256592/Data_logger/04_Fotografie/final-v3/foto-bottom-b.jpg

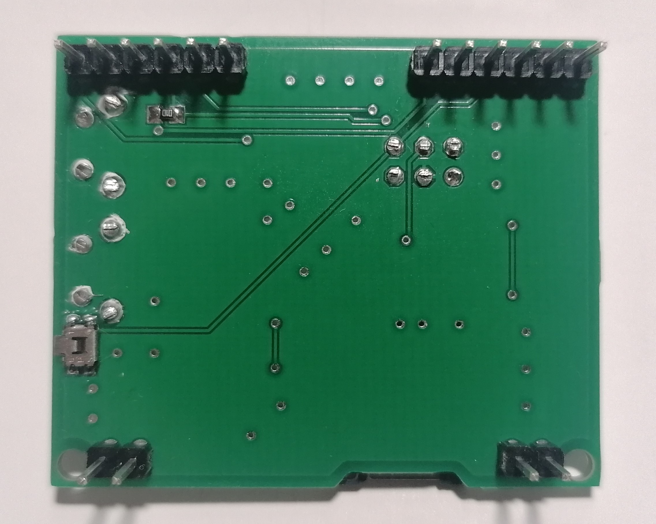
04_Fotografie/final-v3/foto-bottom-b.jpg
