256592/Data_logger/04_Fotografie/final-v3/foto-sestava-01.jpg

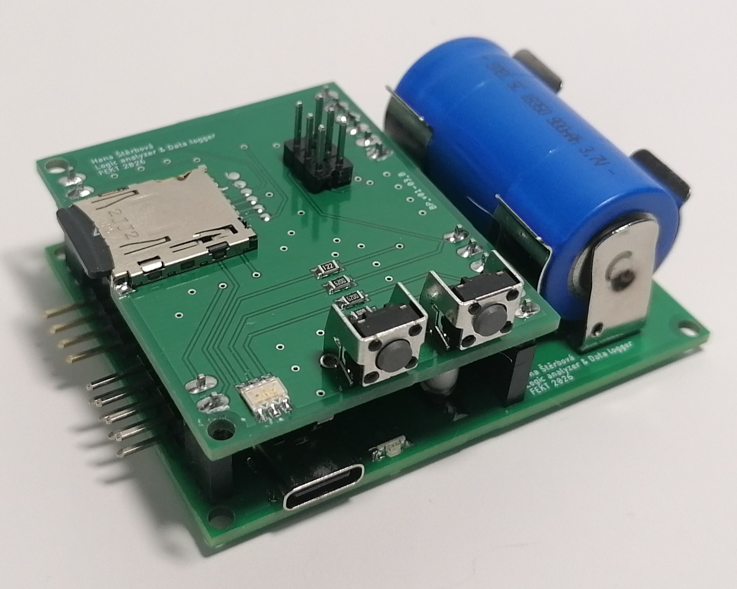
04_Fotografie/final-v3/foto-sestava-01.jpg
