256592/Data_logger/04_Fotografie/final-v3/foto-top-a.jpg

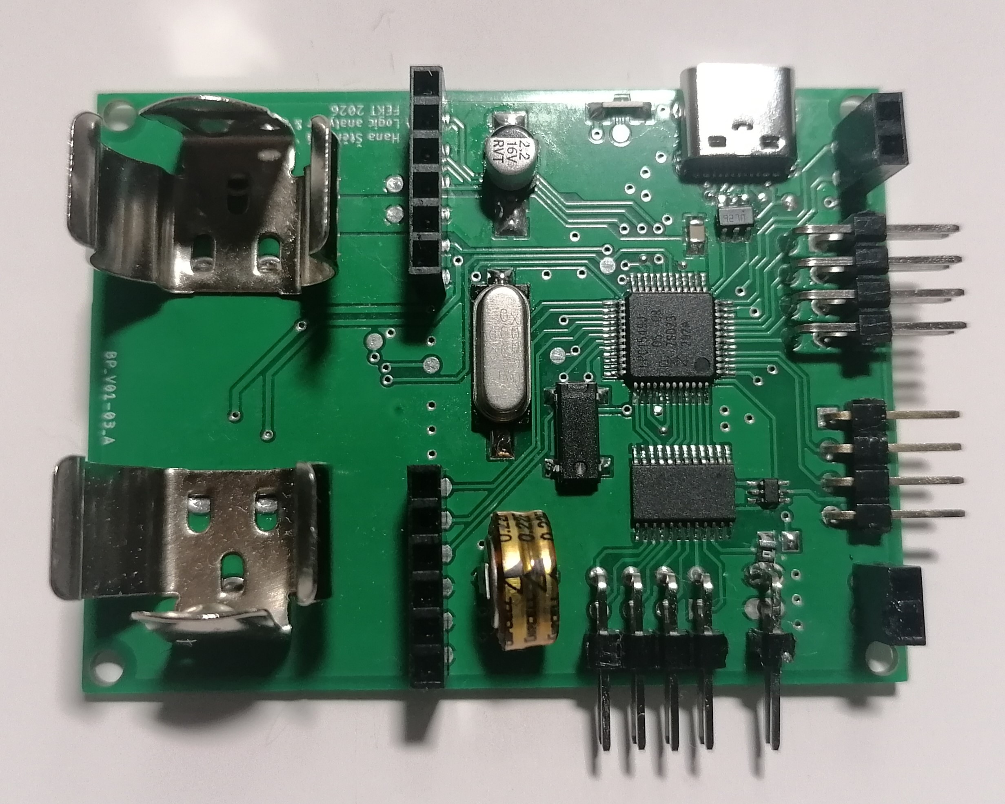
04_Fotografie/final-v3/foto-top-a.jpg
