256592/Data_logger/04_Fotografie/final-v3/foto-top-b.jpg

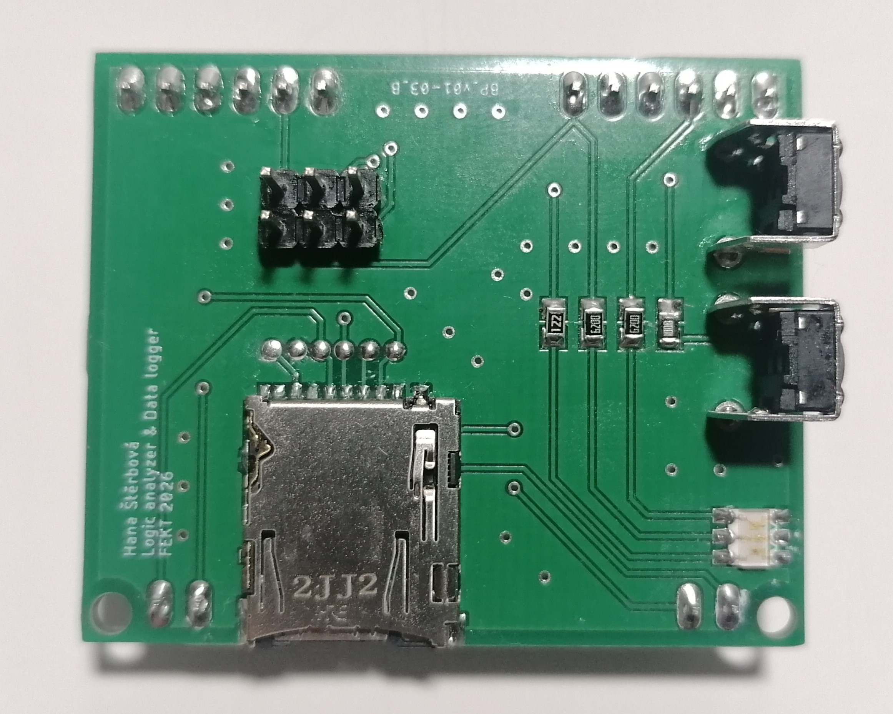
04_Fotografie/final-v3/foto-top-b.jpg
