256592/Data_logger/04_Fotografie/final-v3/krabicka-bottom.jpg

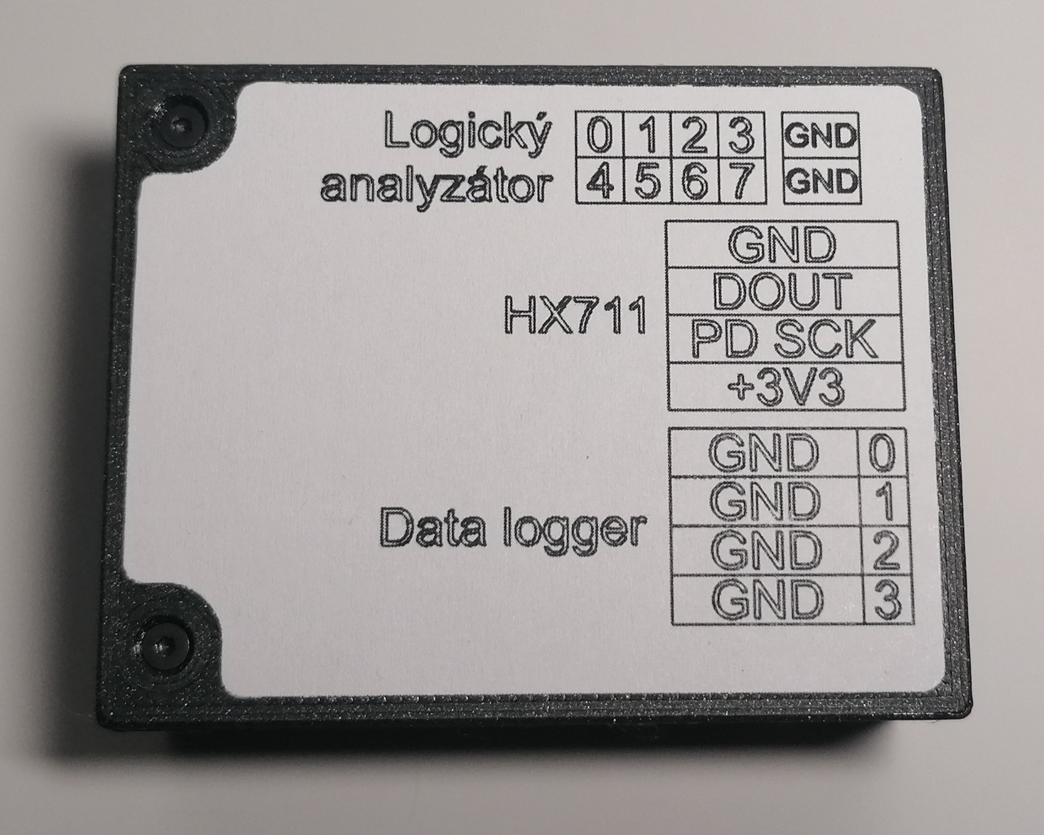
04_Fotografie/final-v3/krabicka-bottom.jpg
