256592/Data_logger/04_Fotografie/final-v3/krabicka-pripojena.jpg

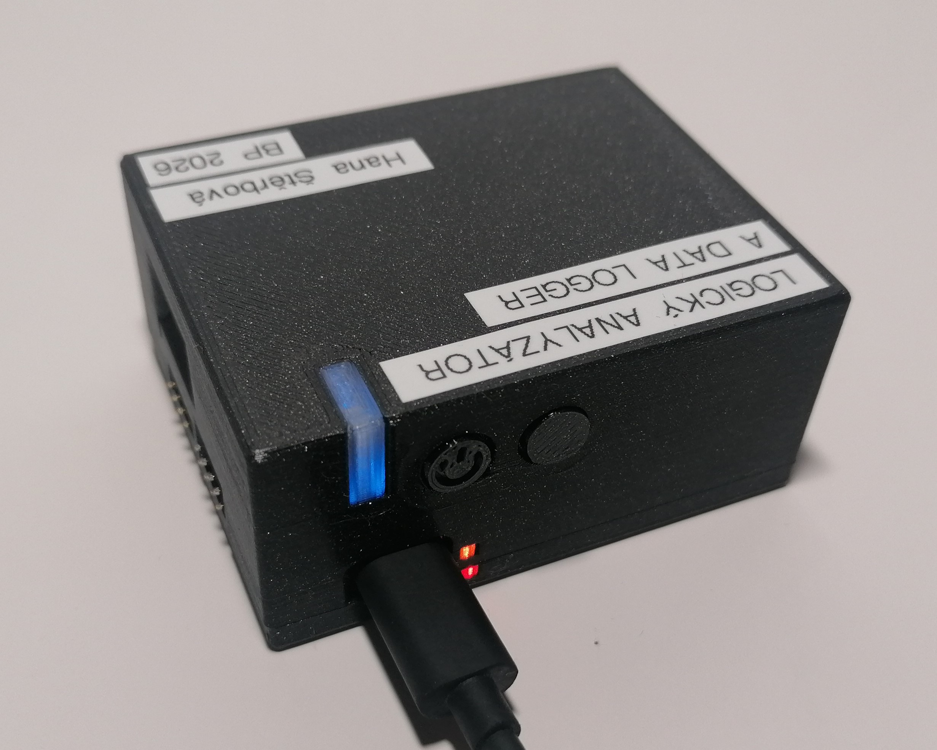
04_Fotografie/final-v3/krabicka-pripojena.jpg
