256592/Data_logger/04_Fotografie/final-v3/krabicka-top-02.jpg

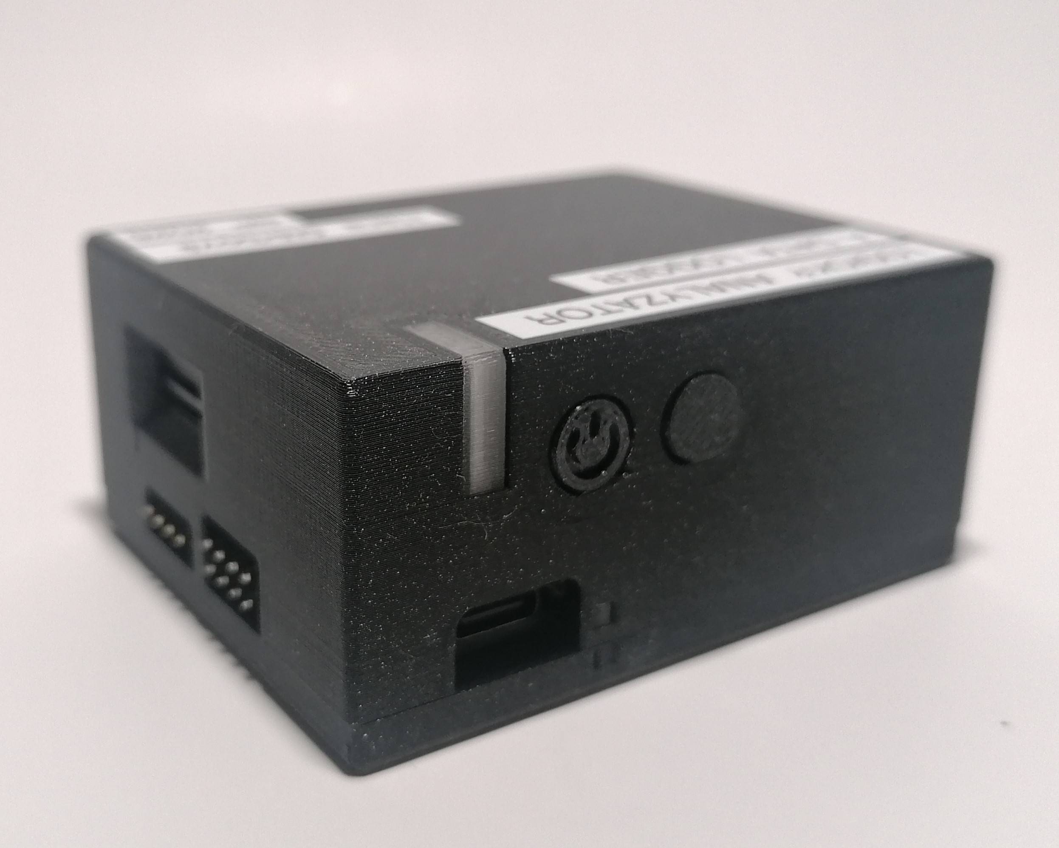
04_Fotografie/final-v3/krabicka-top-02.jpg
