256592/Data_logger/04_Fotografie/osazena-deska-v01-02/osazena-deska-top.jpg

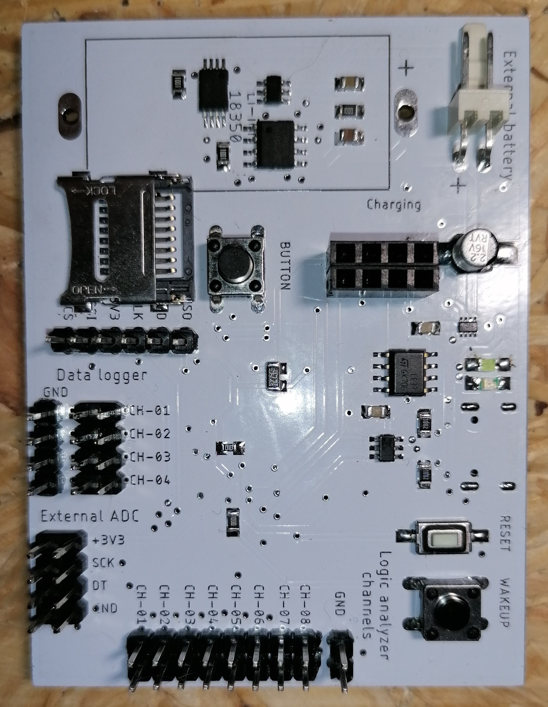
04_Fotografie/osazena-deska-v01-02/osazena-deska-top.jpg
