256592/Data_logger/04_Fotografie/vyroba-dps/DPS.jpg

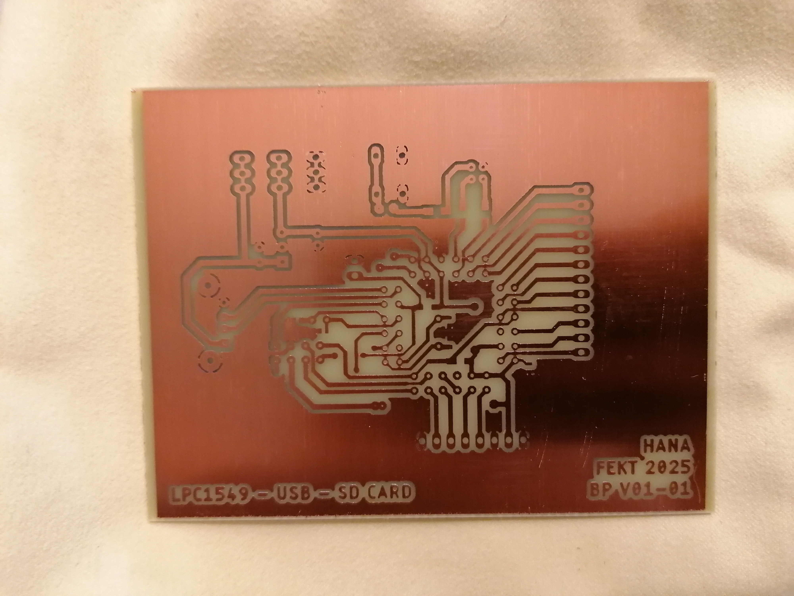
04_Fotografie/vyroba-dps/DPS.jpg
