256592/Data_logger/04_Fotografie/vyroba-dps/DPS_kontrola.jpg

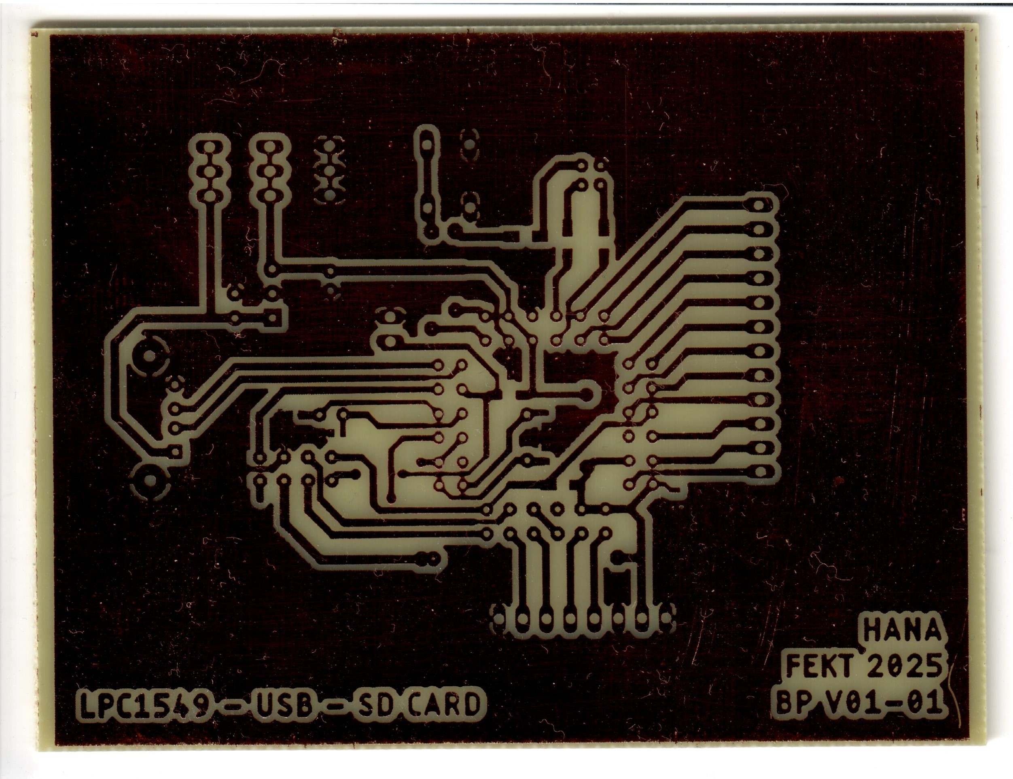
04_Fotografie/vyroba-dps/DPS_kontrola.jpg
