256592/Data_logger/04_Fotografie/vyroba-dps/DPS_leptani.jpg

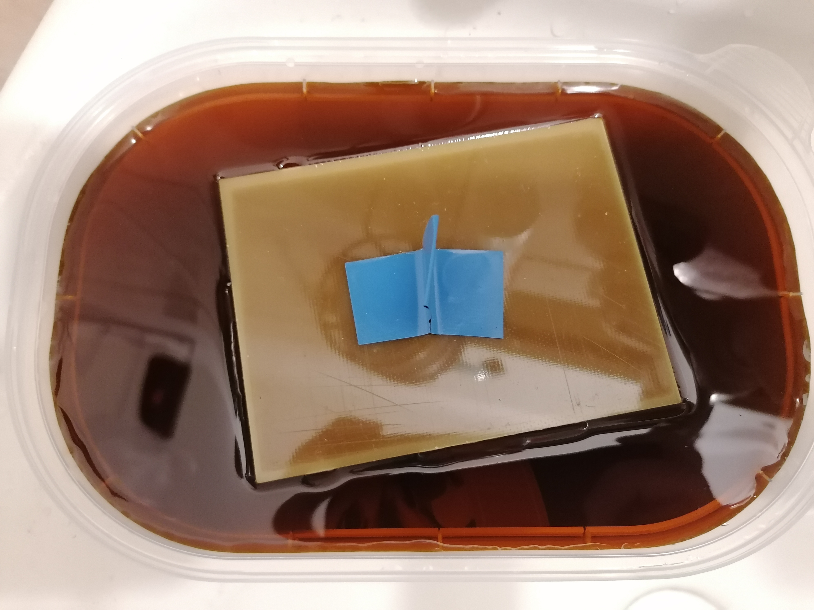
04_Fotografie/vyroba-dps/DPS_leptani.jpg
