256592/Data_logger/00_Hardware/3D modely/Data-logger_v01-02/krytka_BP_rev3.step

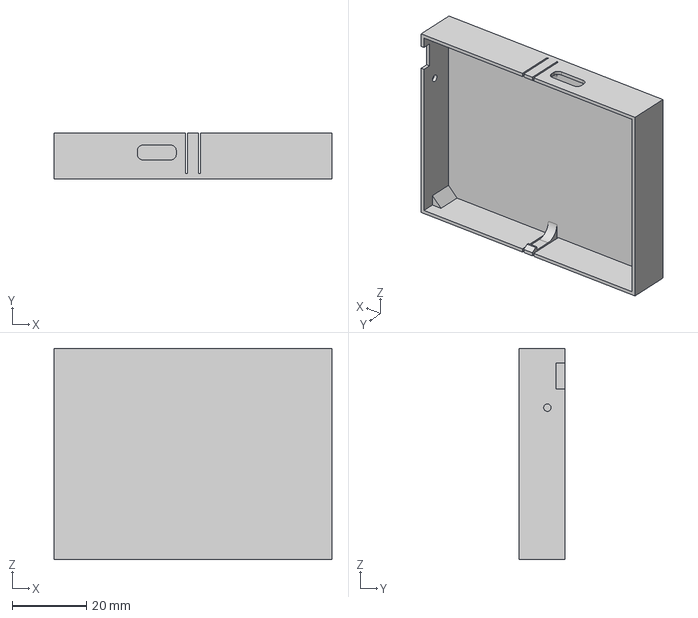
[picture p22: CAD file, 2026-01-06]
00_Hardware/3D modely/Data-logger_v01-02/krytka_BP_rev3.step
75.0 x 12.5 x 57.0 mm
