256592/Data_logger/00_Hardware/3D modely/Data-logger_v01-03/krabicka-spodni.step

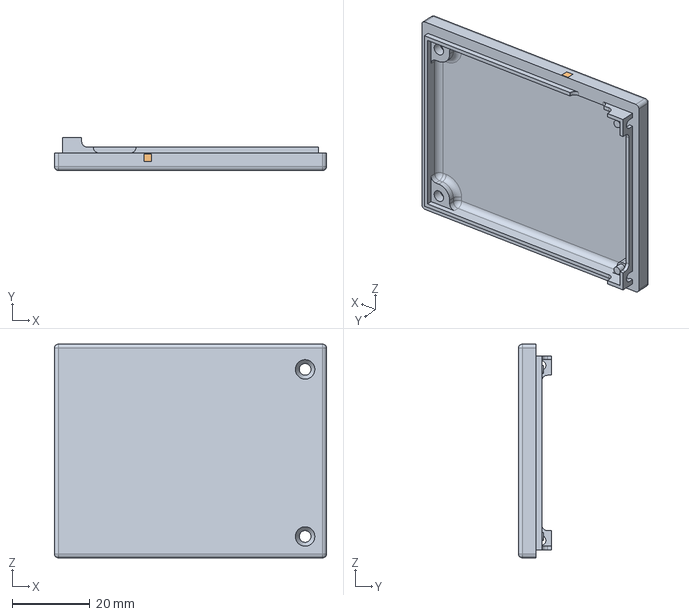
[picture p24: CAD file, 2026-06-03]
00_Hardware/3D modely/Data-logger_v01-03/krabicka-spodni.step
70.0 x 8.50 x 55.0 mm
