256592/Data_logger/00_Hardware/3D modely/Data-logger_v01-03/krabicka-viko.step

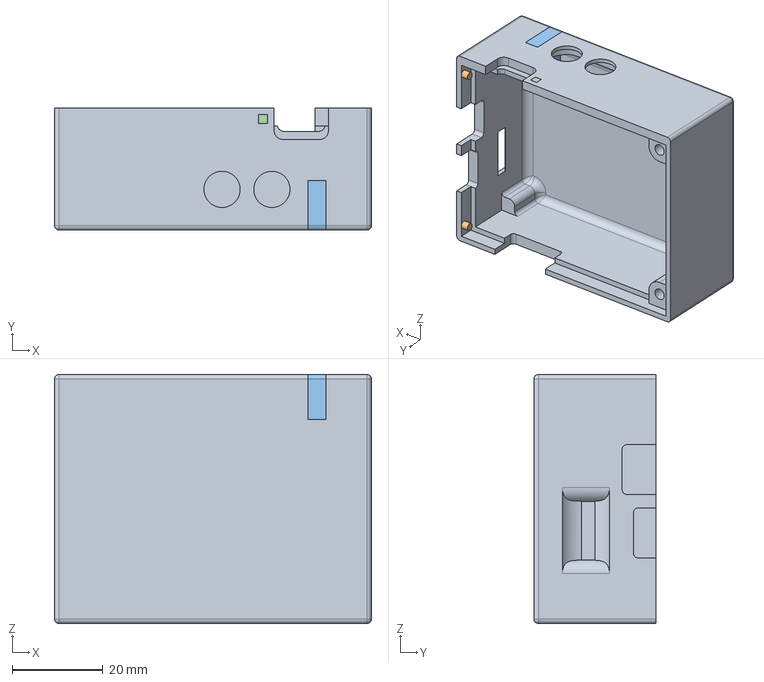
[picture p25: CAD file, 2026-06-03]
00_Hardware/3D modely/Data-logger_v01-03/krabicka-viko.step
70.0 x 27.0 x 55.0 mm
