256592/Data_logger/00_Hardware/3D modely/Data-logger_v01-03/hmatnik.step

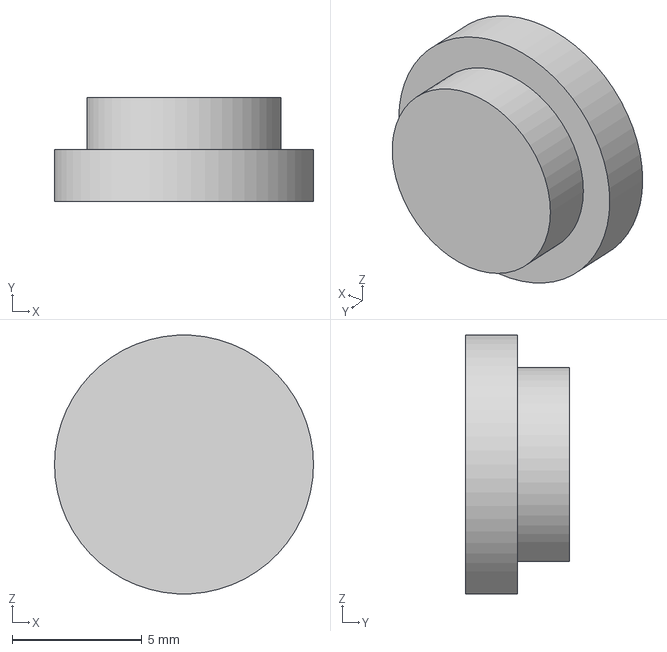
[picture p26: CAD file, 2026-06-03]
00_Hardware/3D modely/Data-logger_v01-03/hmatnik.step
10.0 x 4.00 x 9.99 mm
