256592/Data_logger/02_Software-PC/Test/gui-usb-hid-log-test/hid_log.csv

Time | Value
2026-01-01 03:06:23 | 160
2026-01-01 03:06:24 | 170
2026-01-01 03:06:25 | 174
2026-01-01 03:06:26 | 167
2026-01-01 03:06:27 | 169
2026-01-01 03:06:28 | 168
2026-01-01 03:06:30 | 171
2026-01-01 03:06:31 | 173
2026-01-01 03:06:36 | 172
2026-01-01 03:06:38 | 167
2026-01-01 03:06:41 | 175
2026-01-01 03:06:42 | 171
