256592/Data_logger/00_Hardware/Eagle projekty/Data-logger_v01-03/Data-logger_v01-03.brd

## EAGLE design 00_Hardware/Eagle projekty/Data-logger_v01-03/Data-logger_v01-03.brd (2026-06-03)

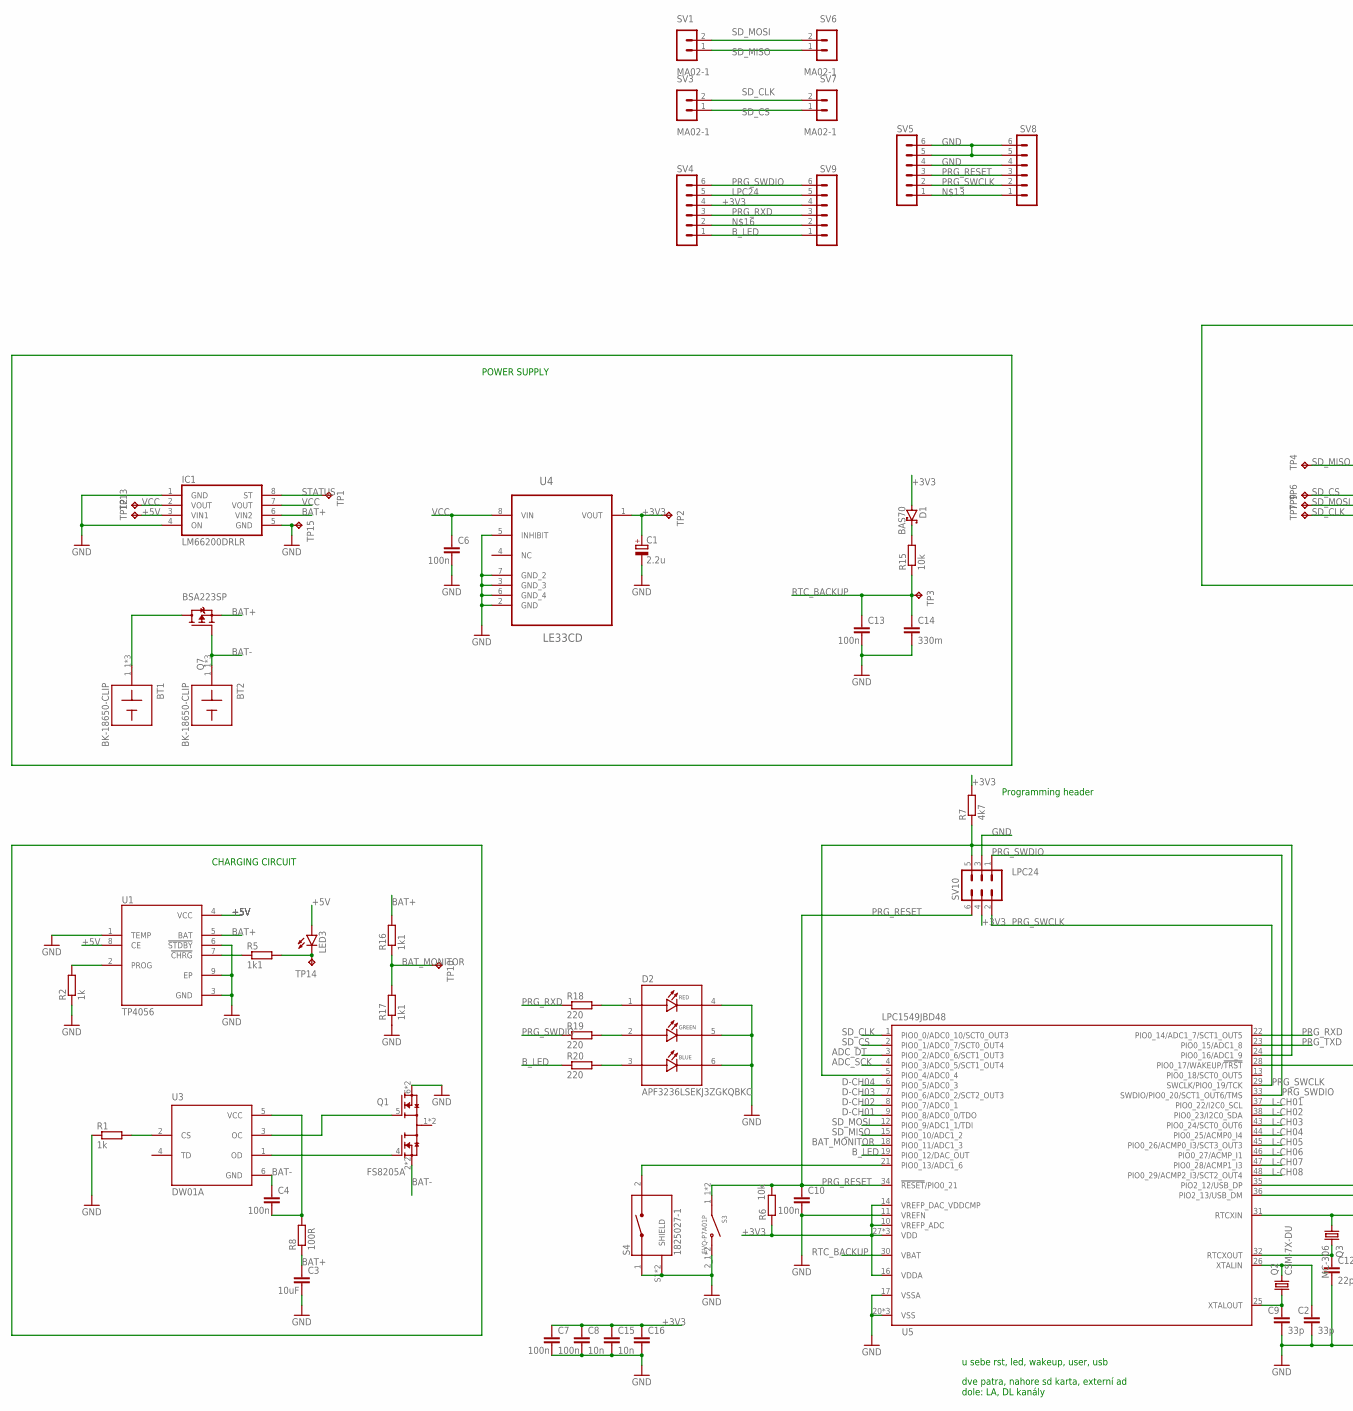
[picture p27: schematic Data-logger_v01-03.sch, part in row 1, column 1]

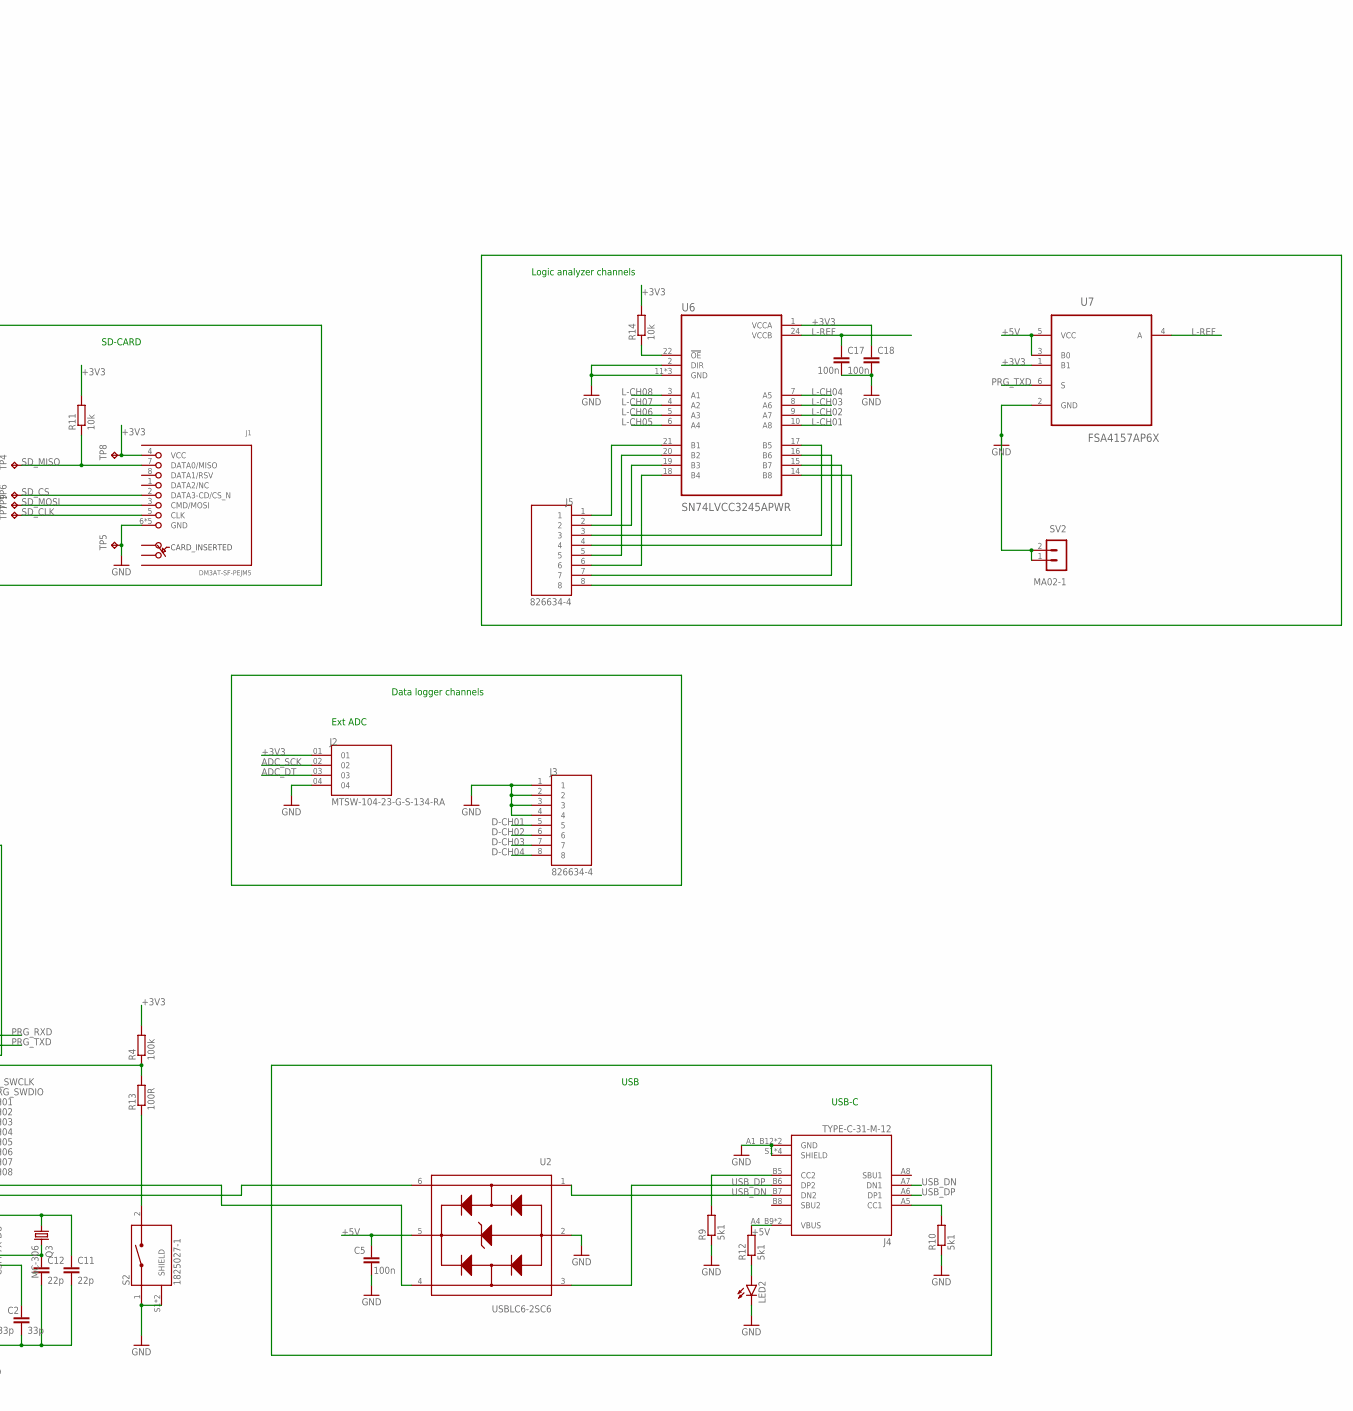
[picture p28: schematic Data-logger_v01-03.sch, part in row 1, column 2]

Parts:
BT1, BT2: BK-18650-CLIP; BAT_BK-18650-CLIP
C1: 2.2u; 140CLH-0810
C2, C9: 33p; C0805
C3: 10uF; C0805
C4, C5, C6, C7, C8, C10, C13, C17, C18: 100n; C0805
C11, C12: 22p; C0805
C14: 330m; C050-050X075
C15, C16: 10n; C0805
D1: BAS70; SOT23
D2: APF3236LSEKJ3ZGKQBKC; LED_APF3236LSEKJ3ZGKQBKC
IC1: LM66200DRLR; SOT8
J1: DM3AT-SF-PEJM5
J2: MTSW-104-23-G-S-134-RA; SAMTEC_MTSW-104-23-G-S-134-RA
J3, J5: 826634-4; TE_826634-4
J4: TYPE-C-31-M-12; HRO_TYPE-C-31-M-12
LED2, LED3: LEDCHIPLED_1206; CHIPLED_1206
Q1: FS8205A; SOP65P640X120-8N
Q2: CSM-7X-DU
Q3: MC-306
Q7: BSA223SP; SC75_INFINEON
R1, R2: 1k; R0805
R4: 100k; R0805
R5, R16, R17: 1k1; R0805
R6, R11, R14, R15: 10k; R0805
R7: 4k7; R0805
R8, R13: 100R; R0805
R9, R10, R12: 5k1; R0805
R18, R19, R20: 220; R0805
S2, S4: 1825027-1; SW_1825027-1
S3: EVQ-P7A01P; SW_EVQ-P7A01P
SV1, SV2, SV3, SV6, SV7: MA02-1
SV4, SV5, SV8, SV9: MA06-1
SV10: MA03-2
TP1, TP2, TP3, TP4, TP5, TP6, TP7, TP8, TP9, TP10, TP12, TP13, TP14, TP15: TPB1,27; B1,27
U1: TP4056; SOP127P600X175-9N
U2: USBLC6-2SC6; SOT95P280X145-6N
U3: DW01A; SOT95P280X145-6N
U4: LE33CD; SOIC127P600X175-8N
U5: LPC1549JBD48; SOT313-2
U6: SN74LVCC3245APWR; SOP65P640X120-24N
U7: FSA4157AP6X; SOT65P210X110-6N

Connections:
+3V3: C1.+, C7.1, C8.1, C15.1, C16.1, C18.1, D1.1 (A), J1.4 (VCC), J2.01, R4.2, R6.1, R7.2, R11.2, R14.2, SV4.4, SV9.4, SV10.4, TP2.TP, TP8.TP, U4.1 (VOUT), U5.10 (VREFP_ADC), U5.14 (VREFP_DAC_VDDCMP), U5.16 (VDDA), U5.27 (VDD), U5.39 (VDD), U5.42 (VDD), U6.1 (VCCA), U7.1 (B1)
+5V: C5.1, IC1.3 (VIN1), J4.A4_B9 (VBUS), J4.B4_A9 (VBUS), LED3.A, R12.2, TP12.TP, U1.4 (VCC), U1.8 (CE), U2.5 (VBUS), U7.3 (B0), U7.5 (VCC)
ADC_DT: J2.03, U5.3 (PIO0_2/ADC0_6/SCT1_OUT3)
ADC_SCK: J2.02, U5.4 (PIO0_3/ADC0_5/SCT1_OUT4)
BAT+: C3.1, IC1.6 (VIN2), Q7.3 (S), R8.1, R16.2, U1.5 (BAT)
BAT-: BT2.1_1, BT2.1_2, BT2.1_3, C4.1, Q1.2 (S1), Q1.3 (S1), Q7.1 (G), U3.6 (GND)
BAT_MONITOR: R16.1, R17.2, TP10.TP, U5.18 (PIO0_11/ADC1_3)
B_LED: R20.1, SV4.1, SV9.1, U5.19 (PIO0_12/DAC_OUT)
D-CH01: J3.5, U5.9 (PIO0_8/ADC0_0/TDO)
D-CH02: J3.6, U5.8 (PIO0_7/ADC0_1)
D-CH03: J3.7, U5.7 (PIO0_6/ADC0_2/SCT2_OUT3)
D-CH04: J3.8, U5.6 (PIO0_5/ADC0_3)
GND: C1.-, C2.2, C3.2, C5.2, C6.2, C7.2, C8.2, C9.2, C10.2, C11.2, C12.2, C13.2, C14.2, C15.2, C16.2, C17.2, C18.2, D2.4 (R_C), D2.5 (G_C), D2.6 (B_C), IC1.1 (GND), IC1.4 (ON), IC1.5 (GND), J1.6 (GND), J1.MOUNT0 (GND), J1.MOUNT1 (GND), J1.MOUNT2 (GND), J1.MOUNT3 (GND), J2.04, J3.1, J3.2, J3.3, J3.4, J4.A1_B12 (GND), J4.B1_A12 (GND), J4.S1 (SHIELD), J4.S2 (SHIELD), J4.S3 (SHIELD), J4.S4 (SHIELD), LED2.C, Q1.6 (S2), Q1.7 (S2), R1.1, R2.1, R9.1, R10.1, R17.1, S2.1, S2.S1 (SHIELD), S2.S2 (SHIELD), S3.2_1 (2), S3.2_2 (2), S4.1, S4.S1 (SHIELD), S4.S2 (SHIELD), SV2.1 (2), SV2.2 (3), SV5.4, SV5.5, SV5.6, SV8.4, SV8.5, SV8.6, SV10.3, TP5.TP, TP15.TP, U1.1 (TEMP), U1.3 (GND), U1.6 (!STDBY), U1.9 (EP), U2.2 (GND), U4.2 (GND), U4.3 (GND_3), U4.5 (INHIBIT), U4.6 (GND_4), U4.7 (GND_2), U5.11 (VREFN), U5.17 (VSSA), U5.20 (VSS), U5.40 (VSS), U5.41 (VSS), U6.2 (DIR), U6.11 (GND), U6.12 (GND), U6.13 (GND), U7.2 (GND)
L-CH01: U5.37 (PIO0_22/I2C0_SCL), U6.10 (A8)
L-CH02: U5.38 (PIO0_23/I2C0_SDA), U6.9 (A7)
L-CH03: U5.43 (PIO0_24/SCT0_OUT6), U6.8 (A6)
L-CH04: U5.44 (PIO0_25/ACMP0_I4), U6.7 (A5)
L-CH05: U5.45 (PIO0_26/ACMP0_I3/SCT3_OUT3), U6.6 (A4)
L-CH06: U5.46 (PIO0_27/ACMP_I1), U6.5 (A3)
L-CH07: U5.47 (PIO0_28/ACMP1_I3), U6.4 (A2)
L-CH08: U5.48 (PIO0_29/ACMP2_I3/SCT2_OUT4), U6.3 (A1)
L-REF: C17.1, U6.24 (VCCB), U7.4 (A)
LPC24: R7.1, SV4.5, SV9.5, SV10.5, U5.5 (PIO0_4/ADC0_4), U5.24 (PIO0_16/ADC1_9)
LPC25: C9.1, Q2.1, U5.25 (XTALOUT)
LPC26: C2.1, Q2.2, U5.26 (XTALIN)
LPC31: C11.1, Q3.1, U5.31 (RTCXIN)
LPC32: C12.1, Q3.4 (2), U5.32 (RTCXOUT)
LPC_DM: U2.4 (I/O2_OUT), U5.35 (PIO2_12/USB_DP)
unnamed: R2.2, U1.2 (PROG)
unnamed: C4.2, R8.2, U3.5 (VCC)
unnamed: R1.2, U3.2 (CS)
unnamed: Q1.4 (G1), U3.1 (OD)
unnamed: Q1.5 (G2), U3.3 (OC)
unnamed: R5.1, U1.7 (!CHRG)
unnamed: J4.A5 (CC1), R10.2
unnamed: LED3.C, R5.2, TP14.TP
unnamed: R4.1, R13.2, SV5.1, SV8.1, U5.28 (PIO0_17/WAKEUP/!TRST)
unnamed: R13.1, S2.2
unnamed: J4.B5 (CC2), R9.2
unnamed: S4.2, SV4.2, SV9.2, U5.21 (PIO0_13/ADC1_6)
unnamed: LED2.A, R12.1
unnamed: J5.1, U6.21 (B1)
unnamed: J5.5, U6.20 (B2)
unnamed: D2.1 (R_A), R18.2
unnamed: D1.3 (C), R15.2
unnamed: D2.2 (G_A), R19.2
unnamed: D2.3 (B_A), R20.2
unnamed: J5.2, U6.19 (B3)
unnamed: BT1.1_1, BT1.1_2, BT1.1_3, Q7.2 (D)
unnamed: J5.6, U6.18 (B4)
unnamed: J5.3, U6.17 (B5)
unnamed: J5.7, U6.16 (B6)
unnamed: J5.8, U6.14 (B8)
unnamed: J5.4, U6.15 (B7)
unnamed: U2.6 (I/O1_OUT), U5.36 (PIO2_13/USB_DM)
unnamed: R14.1, U6.22 (!OE)
PRG_RESET: C10.1, R6.2, S3.1_1 (1), S3.1_2 (1), SV5.3, SV8.3, SV10.6, U5.34 (!RESET!/PIO0_21)
PRG_RXD: R18.1, SV4.3, SV9.3, U5.22 (PIO0_14/ADC1_7/SCT1_OUT5)
PRG_SWCLK: SV5.2, SV8.2, SV10.2, U5.29 (SWCLK/PIO0_19/TCK)
PRG_SWDIO: R19.1, SV4.6, SV9.6, SV10.1, U5.33 (SWDIO/PIO0_20/SCT1_OUT6/TMS)
PRG_TXD: U5.23 (PIO0_15/ADC1_8), U7.6 (S)
RTC_BACKUP: C13.1, C14.1, R15.1, TP3.TP, U5.30 (VBAT)
SD_CLK: J1.5 (CLK), SV3.2 (3), SV7.2 (3), TP7.TP, U5.1 (PIO0_0/ADC0_10/SCT0_OUT3)
SD_CS: J1.2 (DATA3-CD/CS_N), SV3.1 (2), SV7.1 (2), TP6.TP, U5.2 (PIO0_1/ADC0_7/SCT0_OUT4)
SD_MISO: J1.7 (DATA0/MISO), R11.1, SV1.1 (2), SV6.1 (2), TP4.TP, U5.15 (PIO0_10/ADC1_2)
SD_MOSI: J1.3 (CMD/MOSI), SV1.2 (3), SV6.2 (3), TP9.TP, U5.12 (PIO0_9/ADC1_1/TDI)
STATUS: IC1.8 (ST), TP1.TP
USB_DN: J4.A7 (DN1), J4.B7 (DN2), U2.1 (I/O1_IN)
USB_DP: J4.A6 (DP1), J4.B6 (DP2), U2.3 (I/O2_IN)
VCC: C6.1, IC1.2 (VOUT), IC1.7 (VOUT), TP13.TP, U4.8 (VIN)

Notes on the sheet:
USB-C
SD-CARD
POWER SUPPLY
CHARGING CIRCUIT
Programming header
Logic analyzer channels
Data logger channels
Ext ADC
USB
u sebe rst, led, wakeup, user, usb
dve patra, nahore sd karta, externí ad dole: LA, DL kanály

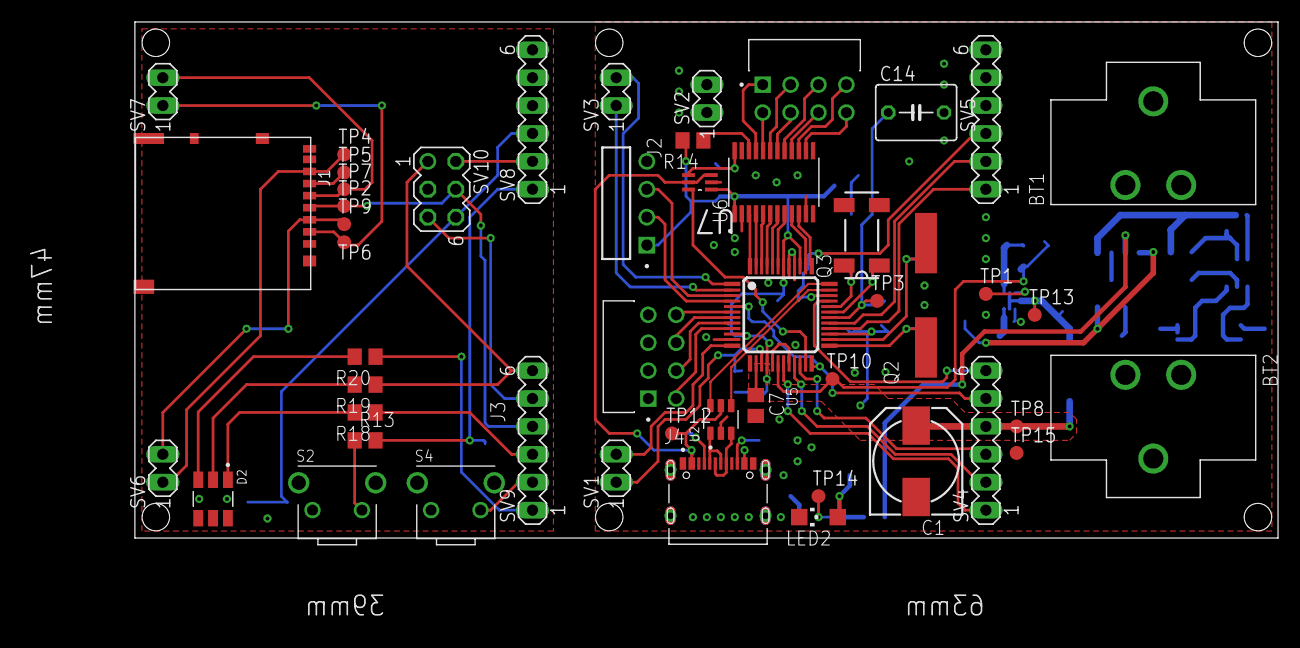
[picture p29: board Data-logger_v01-03.brd from above]

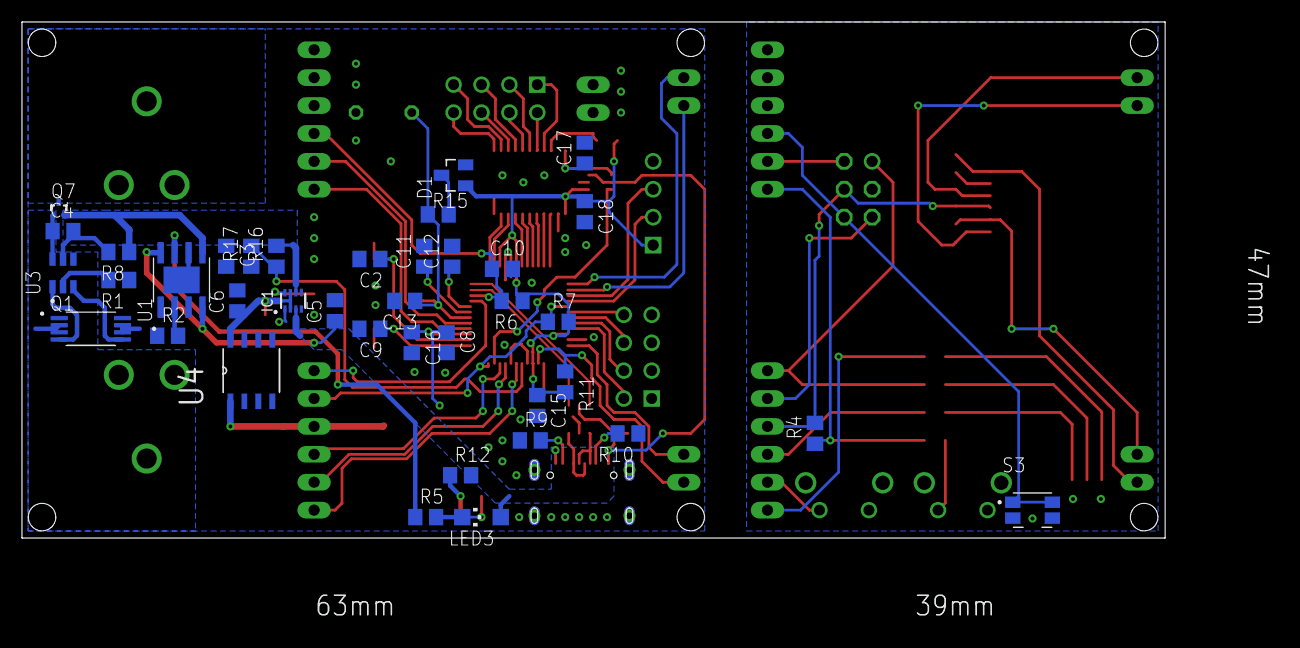
[picture p30: board Data-logger_v01-03.brd from below]

Board: 2 copper layers, 104.1 x 47.0 mm, 87 parts (38 on the bottom side), 70 nets.
