256592/Data_logger/00_Hardware/Eagle projekty/Data-logger_v01-02/Data-logger_v01-02.brd

## EAGLE design 00_Hardware/Eagle projekty/Data-logger_v01-02/Data-logger_v01-02.brd (2025-12-26)

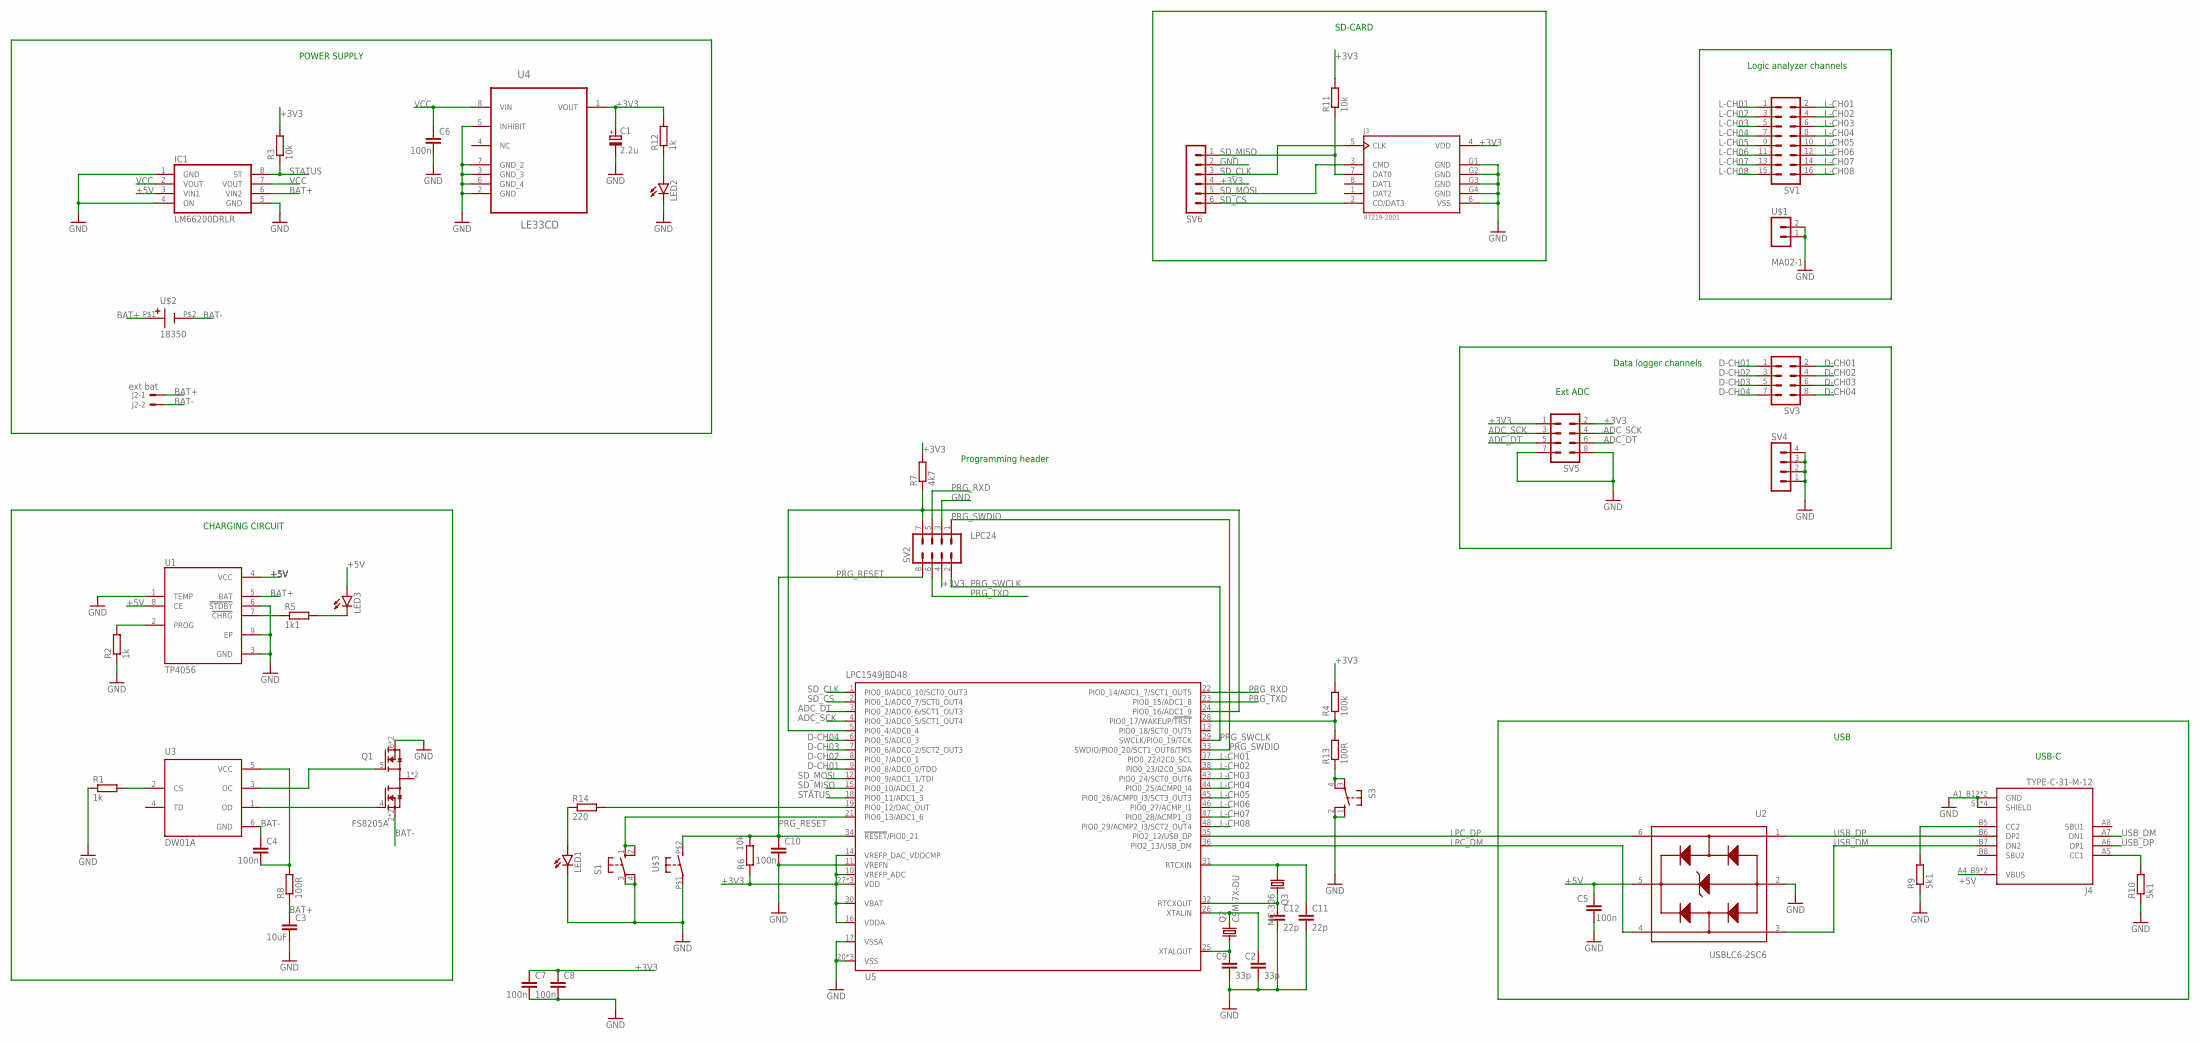
[picture p31: schematic Data-logger_v01-02.sch]

Parts:
C1: 2.2u; 140CLH-0810
C2, C9: 33p; C0805
C3: 10uF; C0805
C4, C5, C6, C7, C8, C10: 100n; C0805
C11, C12: 22p; C0805
IC1: LM66200DRLR; SOT8
J2: ext bat; 7395-02
J3: 47219-2001; MOLEX_47219-2001
J4: TYPE-C-31-M-12; HRO_TYPE-C-31-M-12
LED1, LED2, LED3: LEDCHIPLED_1206; CHIPLED_1206
Q1: FS8205A; SOP65P640X120-8N
Q2: CSM-7X-DU
Q3: MC-306
R1, R2, R12: 1k; R0805
R3, R6, R11: 10k; R0805
R4: 100k; R0805
R5: 1k1; R0805
R7: 4k7; R0805
R8, R13: 100R; R0805
R9, R10: 5k1; R0805
R14: 220; R0805
S1, S3: 10-XX; B3F-10XX
SV1: MA08-2
SV2, SV3, SV5: MA04-2
SV4: MA04-1
SV6: MA06-1
U1: TP4056; SOP127P600X175-9N
U2: USBLC6-2SC6; SOT95P280X145-6N
U3: DW01A; SOT95P280X145-6N
U4: LE33CD; SOIC127P600X175-8N
U5: LPC1549JBD48; SOT313-2
U$1: MA02-1
U$2: 18350
U$3: BUTTON_SMD_MINI; PTS636SP43SMTRLFS

Connections:
+3V3: C1.+, C7.1, C8.1, J3.4 (VDD), R3.2, R4.2, R6.1, R7.2, R11.2, R12.2, SV2.4, SV5.1, SV5.2, SV6.4, U4.1 (VOUT), U5.10 (VREFP_ADC), U5.14 (VREFP_DAC_VDDCMP), U5.16 (VDDA), U5.27 (VDD), U5.30 (VBAT), U5.39 (VDD), U5.42 (VDD)
+5V: C5.1, IC1.3 (VIN1), J4.A4_B9 (VBUS), J4.B4_A9 (VBUS), LED3.A, U1.4 (VCC), U1.8 (CE), U2.5 (VBUS)
ADC_DT: SV5.5, SV5.6, U5.3 (PIO0_2/ADC0_6/SCT1_OUT3)
ADC_SCK: SV5.3, SV5.4, U5.4 (PIO0_3/ADC0_5/SCT1_OUT4)
BAT+: C3.1, IC1.6 (VIN2), J2.1, R8.1, U1.5 (BAT), U$2.P$1 (+)
BAT-: C4.1, J2.2, Q1.2 (S1), Q1.3 (S1), U3.6 (GND), U$2.P$2 (-)
D-CH01: SV3.1, SV3.2, U5.9 (PIO0_8/ADC0_0/TDO)
D-CH02: SV3.3, SV3.4, U5.8 (PIO0_7/ADC0_1)
D-CH03: SV3.5, SV3.6, U5.7 (PIO0_6/ADC0_2/SCT2_OUT3)
D-CH04: SV3.7, SV3.8, U5.6 (PIO0_5/ADC0_3)
GND: C1.-, C2.2, C3.2, C5.2, C6.2, C7.2, C8.2, C9.2, C10.2, C11.2, C12.2, IC1.1 (GND), IC1.4 (ON), IC1.5 (GND), J3.6 (VSS), J3.G1 (GND), J3.G2 (GND), J3.G3 (GND), J3.G4 (GND), J4.A1_B12 (GND), J4.B1_A12 (GND), J4.S1 (SHIELD), J4.S2 (SHIELD), J4.S3 (SHIELD), J4.S4 (SHIELD), LED1.C, LED2.C, Q1.6 (S2), Q1.7 (S2), R1.1, R2.1, R9.1, R10.1, S1.3, S1.4 (P1), S3.1 (S), S3.2 (S1), SV2.3, SV4.1, SV4.2, SV4.3, SV4.4, SV5.7, SV5.8, SV6.2, U1.1 (TEMP), U1.3 (GND), U1.6 (!STDBY), U1.9 (EP), U2.2 (GND), U4.2 (GND), U4.3 (GND_3), U4.5 (INHIBIT), U4.6 (GND_4), U4.7 (GND_2), U5.11 (VREFN), U5.17 (VSSA), U5.20 (VSS), U5.40 (VSS), U5.41 (VSS), U$1.1 (2), U$1.2 (3), U$3.P$1
L-CH01: SV1.1, SV1.2, U5.37 (PIO0_22/I2C0_SCL)
L-CH02: SV1.3, SV1.4, U5.38 (PIO0_23/I2C0_SDA)
L-CH03: SV1.5, SV1.6, U5.43 (PIO0_24/SCT0_OUT6)
L-CH04: SV1.7, SV1.8, U5.44 (PIO0_25/ACMP0_I4)
L-CH05: SV1.9, SV1.10, U5.45 (PIO0_26/ACMP0_I3/SCT3_OUT3)
L-CH06: SV1.11, SV1.12, U5.46 (PIO0_27/ACMP_I1)
L-CH07: SV1.13, SV1.14, U5.47 (PIO0_28/ACMP1_I3)
L-CH08: SV1.15, SV1.16, U5.48 (PIO0_29/ACMP2_I3/SCT2_OUT4)
LPC24: R7.1, SV2.7, U5.5 (PIO0_4/ADC0_4), U5.24 (PIO0_16/ADC1_9)
LPC25: C9.1, Q2.1, U5.25 (XTALOUT)
LPC26: C2.1, Q2.2, U5.26 (XTALIN)
LPC31: C11.1, Q3.1, U5.31 (RTCXIN)
LPC32: C12.1, Q3.4 (2), U5.32 (RTCXOUT)
LPC_DM: U2.4 (I/O2_OUT), U5.36 (PIO2_13/USB_DM)
LPC_DP: U2.6 (I/O1_OUT), U5.35 (PIO2_12/USB_DP)
unnamed: R2.2, U1.2 (PROG)
unnamed: C4.2, R8.2, U3.5 (VCC)
unnamed: R1.2, U3.2 (CS)
unnamed: Q1.4 (G1), U3.1 (OD)
unnamed: Q1.5 (G2), U3.3 (OC)
unnamed: R5.1, U1.7 (!CHRG)
unnamed: J4.A5 (CC1), R10.2
unnamed: LED3.C, R5.2
unnamed: R4.1, R13.2, U5.28 (PIO0_17/WAKEUP/!TRST)
unnamed: R13.1, S3.3, S3.4 (P1)
unnamed: J4.B5 (CC2), R9.2
unnamed: S1.1 (S), S1.2 (S1), U5.21 (PIO0_13/ADC1_6)
unnamed: LED2.A, R12.1
unnamed: LED1.A, R14.1
unnamed: R14.2, U5.19 (PIO0_12/DAC_OUT)
PRG_RESET: C10.1, R6.2, SV2.8, U5.34 (!RESET!/PIO0_21), U$3.P$2 (S)
PRG_RXD: SV2.5, U5.22 (PIO0_14/ADC1_7/SCT1_OUT5)
PRG_SWCLK: SV2.2, U5.29 (SWCLK/PIO0_19/TCK)
PRG_SWDIO: SV2.1, U5.33 (SWDIO/PIO0_20/SCT1_OUT6/TMS)
PRG_TXD: SV2.6, U5.23 (PIO0_15/ADC1_8)
SD_CLK: J3.5 (CLK), SV6.3, U5.1 (PIO0_0/ADC0_10/SCT0_OUT3)
SD_CS: J3.2 (CD/DAT3), SV6.6, U5.2 (PIO0_1/ADC0_7/SCT0_OUT4)
SD_MISO: J3.7 (DAT0), R11.1, SV6.1, U5.15 (PIO0_10/ADC1_2)
SD_MOSI: J3.3 (CMD), SV6.5, U5.12 (PIO0_9/ADC1_1/TDI)
STATUS: IC1.8 (ST), R3.1, U5.18 (PIO0_11/ADC1_3)
USB_DM: J4.A7 (DN1), J4.B7 (DN2), U2.3 (I/O2_IN)
USB_DP: J4.A6 (DP1), J4.B6 (DP2), U2.1 (I/O1_IN)
VCC: C6.1, IC1.2 (VOUT), IC1.7 (VOUT), U4.8 (VIN)

Notes on the sheet:
USB-C
SD-CARD
POWER SUPPLY
CHARGING CIRCUIT
Programming header
Logic analyzer channels
Data logger channels
Ext ADC
USB

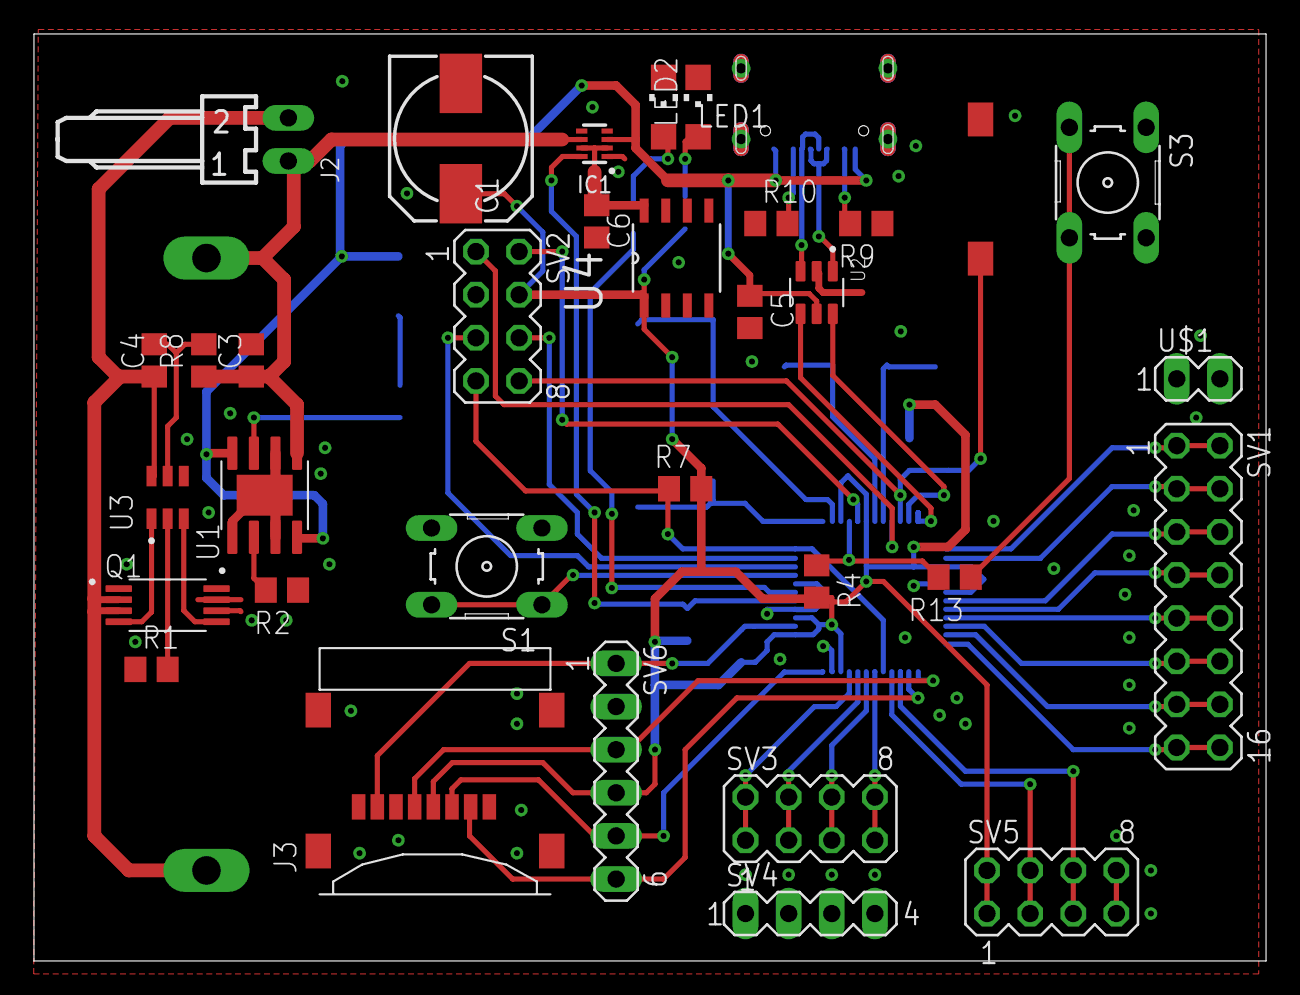
[picture p32: board Data-logger_v01-02.brd from above]

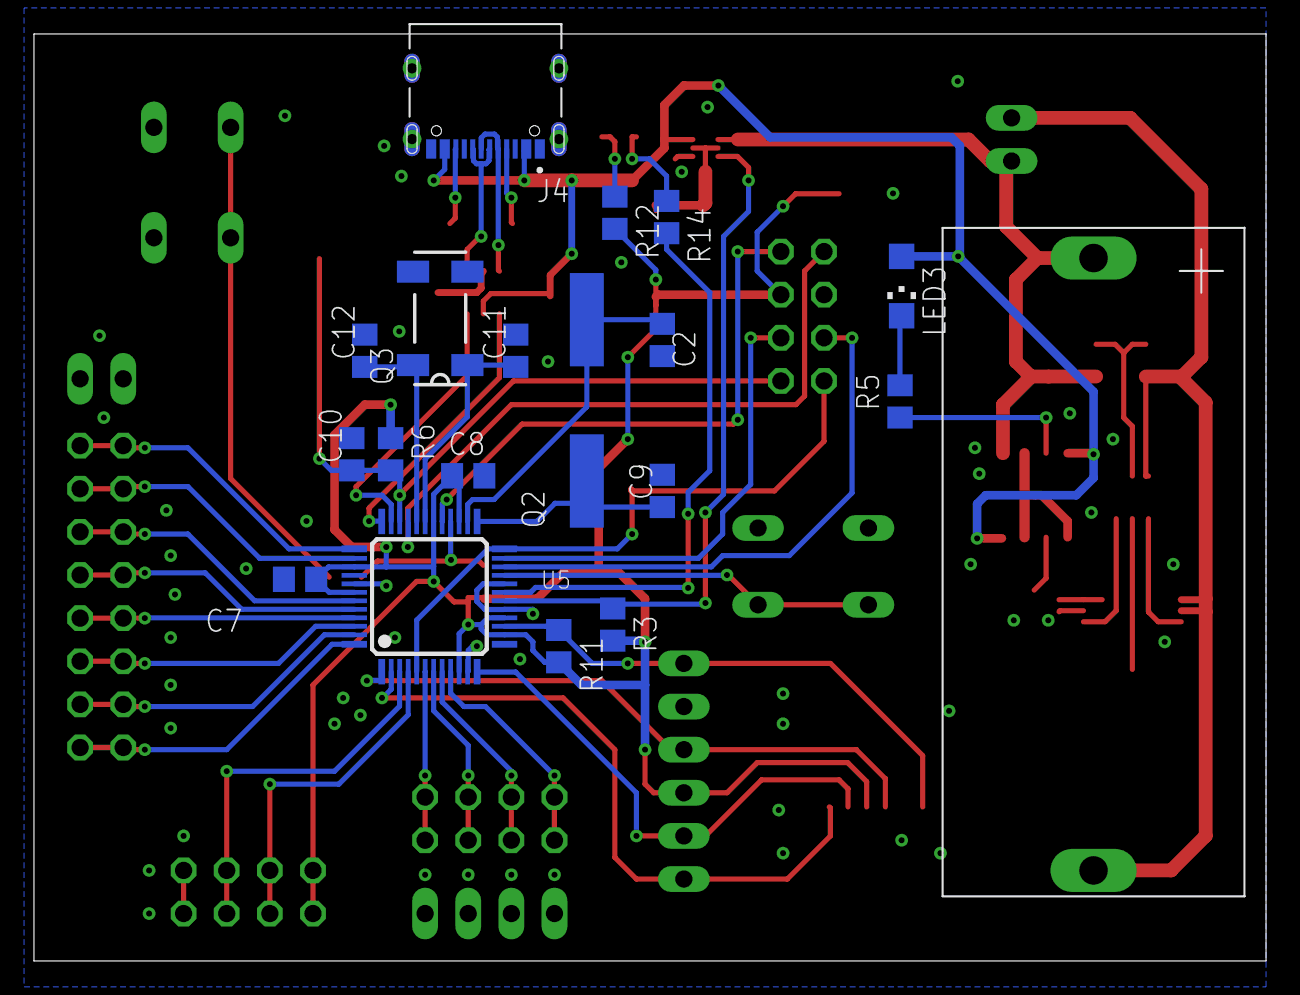
[picture p33: board Data-logger_v01-02.brd from below]

Board: 2 copper layers, 72.6 x 54.6 mm, 52 parts (19 on the bottom side), 54 nets.
