256592/Data_logger/00_Hardware/Eagle projekty/Data-logger_v01-01/Data-logger_v01-01.brd

## EAGLE design 00_Hardware/Eagle projekty/Data-logger_v01-01/Data-logger_v01-01.brd (2025-10-21)

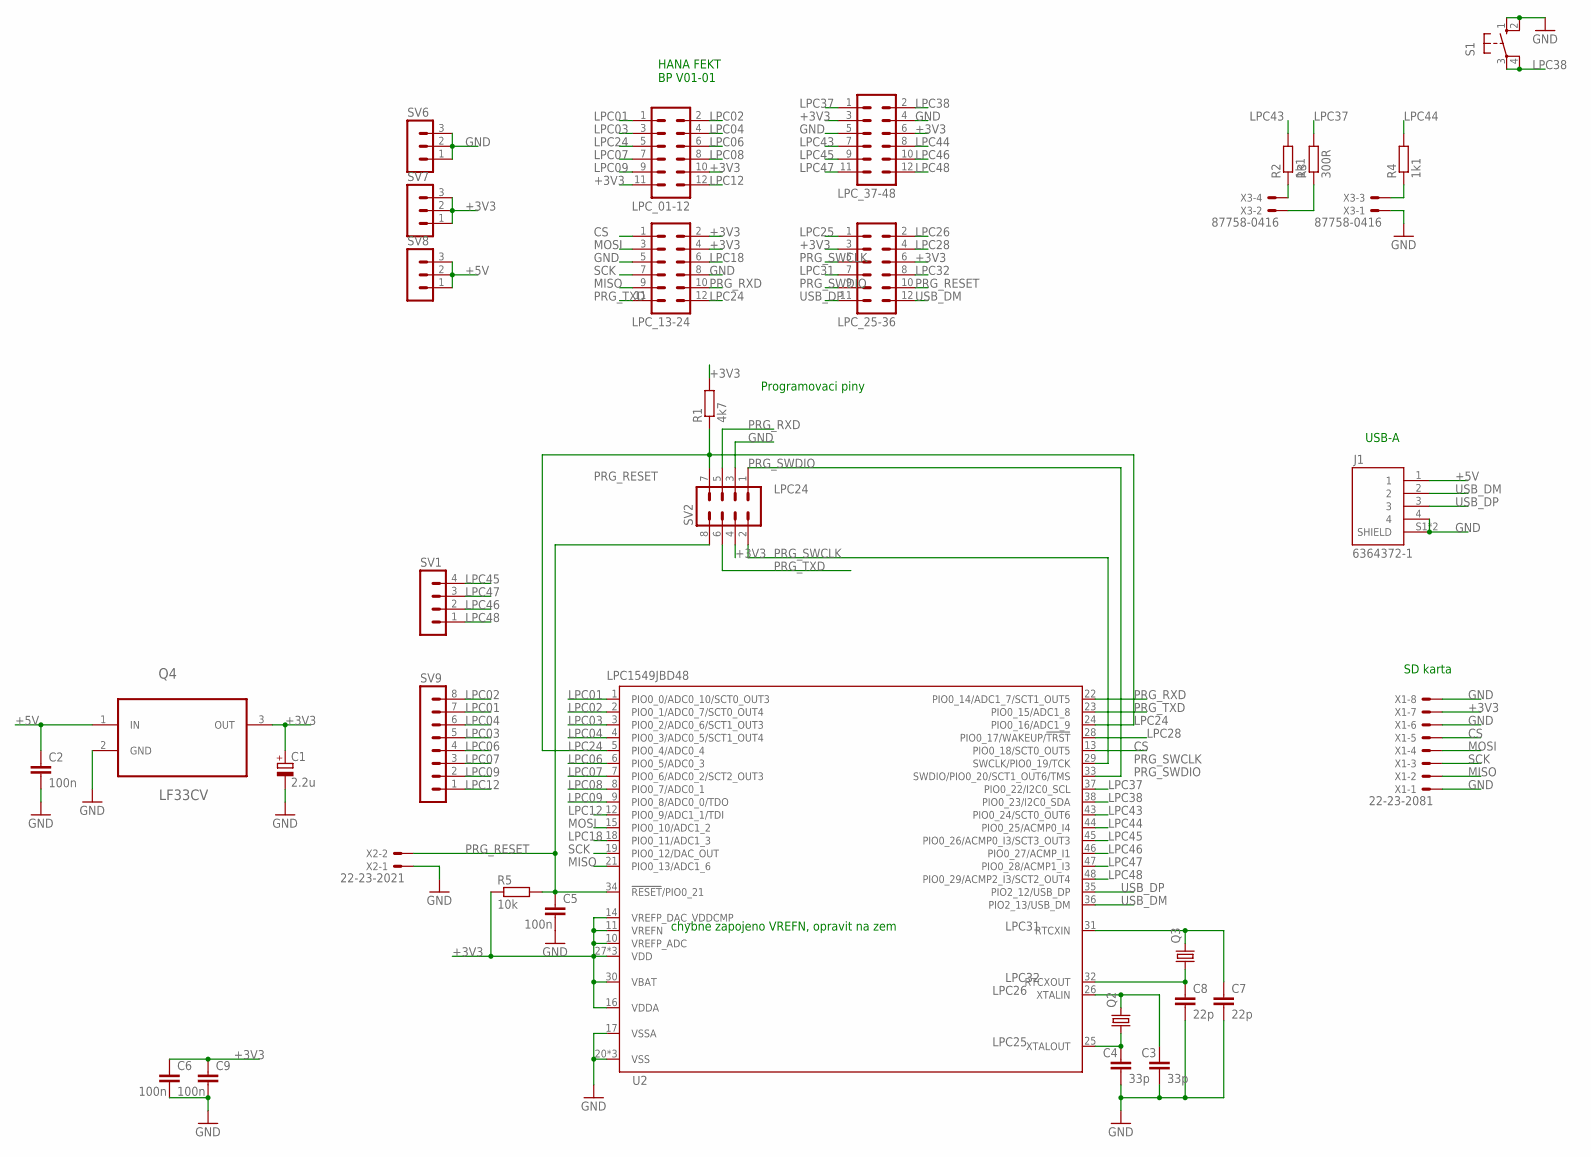
[picture p34: schematic Data-logger_v01-01.sch]

Parts:
C1: 2.2u; E2-4
C2: 100n; C025-024X044
C3, C4: 33p; C0402
C5, C6, C9: 100n; C0402
C7, C8: 22p; C0402
J1: 6364372-1; TE_6364372-1
LPC_01-12, LPC_13-24, LPC_25-36, LPC_37-48: MA06-2
Q2: CRYSTALHC49S; HC49/S
Q3: CRYSTALTC26H; TC26H
Q4: LF33CV; TO254P450X1020X1935-3P
R1: 4k7; R1206W
R2, R4: 1k1; R1206W
R3: 300R; R1206W
R5: 10k; R1206W
S1: 10-XX; B3F-10XX
SV1: MA04-1
SV2: MA04-2
SV6, SV7, SV8: MA03-1
SV9: MA08-1
U2: LPC1549JBD48; SOT313-2
X1: 22-23-2081
X2: 22-23-2021
X3: 87758-0416

Connections:
+3V3: C1.+, C6.1, C9.1, LPC_01-12.10, LPC_01-12.11, LPC_13-24.2, LPC_13-24.4, LPC_25-36.3, LPC_25-36.6, LPC_37-48.3, LPC_37-48.6, Q4.3 (OUT), R1.2, R5.1, SV2.4, SV7.1, SV7.2, SV7.3, U2.10 (VREFP_ADC), U2.11 (VREFN), U2.14 (VREFP_DAC_VDDCMP), U2.16 (VDDA), U2.27 (VDD), U2.30 (VBAT), U2.39 (VDD), U2.42 (VDD), X1.7
+5V: C2.1, J1.1, Q4.1 (IN), SV8.1, SV8.2, SV8.3
CS: LPC_13-24.1, U2.13 (PIO0_18/SCT0_OUT5), X1.5
GND: C1.-, C2.2, C3.2, C4.2, C5.2, C6.2, C7.2, C8.2, C9.2, J1.4, J1.S1 (SHIELD), J1.S2 (SHIELD), LPC_13-24.5, LPC_13-24.8, LPC_37-48.4, LPC_37-48.5, Q4.2 (GND), S1.1 (S), S1.2 (S1), SV2.3, SV6.1, SV6.2, SV6.3, U2.17 (VSSA), U2.20 (VSS), U2.40 (VSS), U2.41 (VSS), X1.1, X1.6, X1.8, X2.1, X3.1
LPC01: LPC_01-12.1, SV9.7, U2.1 (PIO0_0/ADC0_10/SCT0_OUT3)
LPC02: LPC_01-12.2, SV9.8, U2.2 (PIO0_1/ADC0_7/SCT0_OUT4)
LPC03: LPC_01-12.3, SV9.5, U2.3 (PIO0_2/ADC0_6/SCT1_OUT3)
LPC04: LPC_01-12.4, SV9.6, U2.4 (PIO0_3/ADC0_5/SCT1_OUT4)
LPC06: LPC_01-12.6, SV9.4, U2.6 (PIO0_5/ADC0_3)
LPC07: LPC_01-12.7, SV9.3, U2.7 (PIO0_6/ADC0_2/SCT2_OUT3)
LPC08: LPC_01-12.8, U2.8 (PIO0_7/ADC0_1)
LPC09: LPC_01-12.9, SV9.2, U2.9 (PIO0_8/ADC0_0/TDO)
LPC12: LPC_01-12.12, SV9.1, U2.12 (PIO0_9/ADC1_1/TDI)
LPC18: LPC_13-24.6, U2.18 (PIO0_11/ADC1_3)
LPC24: LPC_01-12.5, LPC_13-24.12, R1.1, SV2.7, U2.5 (PIO0_4/ADC0_4), U2.24 (PIO0_16/ADC1_9)
LPC25: C4.1, LPC_25-36.1, Q2.1, U2.25 (XTALOUT)
LPC26: C3.1, LPC_25-36.2, Q2.2, U2.26 (XTALIN)
LPC28: LPC_25-36.4, U2.28 (PIO0_17/WAKEUP/!TRST)
LPC31: C7.1, LPC_25-36.7, Q3.2, U2.31 (RTCXIN)
LPC32: C8.1, LPC_25-36.8, Q3.1, U2.32 (RTCXOUT)
LPC37: LPC_37-48.1, R3.2, U2.37 (PIO0_22/I2C0_SCL)
LPC38: LPC_37-48.2, S1.3, S1.4 (P1), U2.38 (PIO0_23/I2C0_SDA)
LPC43: LPC_37-48.7, R2.2, U2.43 (PIO0_24/SCT0_OUT6)
LPC44: LPC_37-48.8, R4.2, U2.44 (PIO0_25/ACMP0_I4)
LPC45: LPC_37-48.9, SV1.4, U2.45 (PIO0_26/ACMP0_I3/SCT3_OUT3)
LPC46: LPC_37-48.10, SV1.2, U2.46 (PIO0_27/ACMP_I1)
LPC47: LPC_37-48.11, SV1.3, U2.47 (PIO0_28/ACMP1_I3)
LPC48: LPC_37-48.12, SV1.1, U2.48 (PIO0_29/ACMP2_I3/SCT2_OUT4)
MISO: LPC_13-24.9, U2.21 (PIO0_13/ADC1_6), X1.2
MOSI: LPC_13-24.3, U2.15 (PIO0_10/ADC1_2), X1.4
unnamed: R2.1, X3.4
unnamed: R3.1, X3.2
unnamed: R4.1, X3.3
PRG_RESET: C5.1, LPC_25-36.10, R5.2, SV2.8, U2.34 (!RESET!/PIO0_21), X2.2
PRG_RXD: LPC_13-24.10, SV2.5, U2.22 (PIO0_14/ADC1_7/SCT1_OUT5)
PRG_SWCLK: LPC_25-36.5, SV2.2, U2.29 (SWCLK/PIO0_19/TCK)
PRG_SWDIO: LPC_25-36.9, SV2.1, U2.33 (SWDIO/PIO0_20/SCT1_OUT6/TMS)
PRG_TXD: LPC_13-24.11, SV2.6, U2.23 (PIO0_15/ADC1_8)
SCK: LPC_13-24.7, U2.19 (PIO0_12/DAC_OUT), X1.3
USB_DM: J1.2, LPC_25-36.12, U2.36 (PIO2_13/USB_DM)
USB_DP: J1.3, LPC_25-36.11, U2.35 (PIO2_12/USB_DP)

Notes on the sheet:
HANA FEKT BP V01-01
SD karta
USB-A
Programovaci piny
chybne zapojeno VREFN, opravit na zem

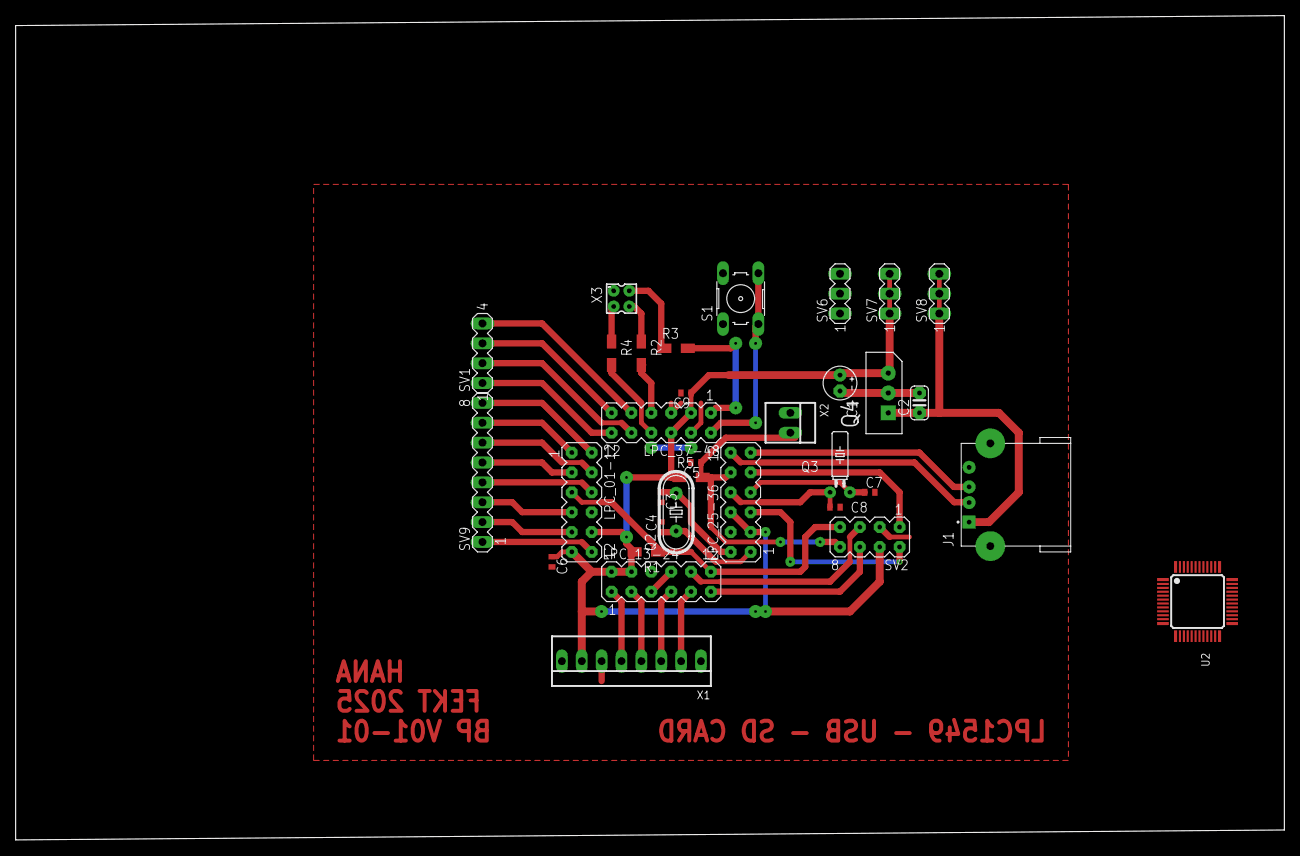
[picture p35: board Data-logger_v01-01.brd from above]

Board: 2 copper layers, 162.2 x 105.4 mm, 33 parts (0 on the bottom side), 41 nets.
