256592/Data_logger/01_Firmware-LPC/Test/USB_HID_TEST/usbd_rom_hid_generic/example/src/hid_main.c

/*
 * @brief HID generic example
 *
 * @note
 * Copyright(C) NXP Semiconductors, 2013
 * All rights reserved.
 *
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
 * @par
 * Permission to use, copy, modify, and distribute this software and its
 * documentation is hereby granted, under NXP Semiconductors' and its
 * licensor's relevant copyrights in the software, without fee, provided that it
 * is used in conjunction with NXP Semiconductors microcontrollers.  This
 * copyright, permission, and disclaimer notice must appear in all copies of
 * this code.
 */

#include "board.h"
#include <stdio.h>
#include <string.h>
#include "app_usbd_cfg.h"
#include "hid_generic.h"

#define R_LED	17
#define G_LED	24
#define B_LED	25

/*#define R_ON
#define R_OFF
#define G_ON
#define G_OFF
#define B_ON
#define B_OFF*/

// XXXXX BGR & 00000 010
// potom pro priklad od indexu 4 do indexu 64 data, jinak adresy a kontrola

/*****************************************************************************
 * Private types/enumerations/variables
 ****************************************************************************/

/*****************************************************************************
 * Public types/enumerations/variables
 ****************************************************************************/

static USBD_HANDLE_T g_hUsb;
const  USBD_API_T *g_pUsbApi;
volatile uint32_t casovac1ms;
uint8_t pc_out_report[64];
uint8_t pc_in_report[64];
/*****************************************************************************
 * Private functions
 ****************************************************************************/

/*****************************************************************************
 * Public functions
 ****************************************************************************/

/**
 * @brief	Handle interrupt from USB
 * @return	Nothing
 */
void USB_IRQHandler(void)
{
	USBD_API->hw->ISR(g_hUsb);
}

/* Find the address of interface descriptor for given class type. */
USB_INTERFACE_DESCRIPTOR *find_IntfDesc(const uint8_t *pDesc, uint32_t intfClass)
{
	USB_COMMON_DESCRIPTOR *pD;
	USB_INTERFACE_DESCRIPTOR *pIntfDesc = 0;
	uint32_t next_desc_adr;

	pD = (USB_COMMON_DESCRIPTOR *) pDesc;
	next_desc_adr = (uint32_t) pDesc;

	while (pD->bLength) {
		/* is it interface descriptor */
		if (pD->bDescriptorType == USB_INTERFACE_DESCRIPTOR_TYPE) {

			pIntfDesc = (USB_INTERFACE_DESCRIPTOR *) pD;
			/* did we find the right interface descriptor */
			if (pIntfDesc->bInterfaceClass == intfClass) {
				break;
			}
		}
		pIntfDesc = 0;
		next_desc_adr = (uint32_t) pD + pD->bLength;
		pD = (USB_COMMON_DESCRIPTOR *) next_desc_adr;
	}

	return pIntfDesc;
}

/**
 * @brief	main routine for blinky example
 * @return	Function should not exit.
 */
int main(void)

// dopsat VID - idVendor, PID - idProduct v hid_desc.c

{
	USBD_API_INIT_PARAM_T usb_param;
	USB_CORE_DESCS_T desc;
	ErrorCode_t ret = LPC_OK;

	/* Initialize board and chip */
	Board_Init();


	/* enable clocks */
	Chip_USB_Init();

	/* initialize USBD ROM API pointer. */
	g_pUsbApi = (const USBD_API_T *) LPC_ROM_API->pUSBD;

	/* initialize call back structures */
	memset((void *) &usb_param, 0, sizeof(USBD_API_INIT_PARAM_T));
	usb_param.usb_reg_base = LPC_USB0_BASE;
	/*	WORKAROUND for artf44835 ROM driver BUG:
	    Code clearing STALL bits in endpoint reset routine corrupts memory area
	    next to the endpoint control data. For example When EP0, EP1_IN, EP1_OUT,
	    EP2_IN are used we need to specify 3 here. But as a workaround for this
	    issue specify 4. So that extra EPs control structure acts as padding buffer
	    to avoid data corruption. Corruption of padding memory doesn’t affect the
	    stack/program behaviour.
	 */
	usb_param.max_num_ep = 2 + 1;
	usb_param.mem_base = USB_STACK_MEM_BASE;
	usb_param.mem_size = USB_STACK_MEM_SIZE;

	/* Set the USB descriptors */
	desc.device_desc = (uint8_t *) USB_DeviceDescriptor;
	desc.string_desc = (uint8_t *) USB_StringDescriptor;

	/* Note, to pass USBCV test full-speed only devices should have both
	 * descriptor arrays point to same location and device_qualifier set
	 * to 0.
	 */
	desc.high_speed_desc = USB_FsConfigDescriptor;
	desc.full_speed_desc = USB_FsConfigDescriptor;
	desc.device_qualifier = 0;

	/* USB Initialization */
	ret = USBD_API->hw->Init(&g_hUsb, &desc, &usb_param);
	if (ret == LPC_OK) {

		ret =
			usb_hid_init(g_hUsb,
						 (USB_INTERFACE_DESCRIPTOR *) &USB_FsConfigDescriptor[sizeof(USB_CONFIGURATION_DESCRIPTOR)],
						 &usb_param.mem_base, &usb_param.mem_size);
		if (ret == LPC_OK) {
			/*  enable USB interrupts */
			NVIC_EnableIRQ(USB0_IRQn);
			/* now connect */
			USBD_API->hw->Connect(g_hUsb, 1);
		}

	}

	Chip_RIT_Init(LPC_RITIMER);
    Chip_RIT_SetTimerIntervalHz(LPC_RITIMER,1000);
    LPC_RITIMER->CTRL = (1<<1) | (1<<3);
    //nejnižší priorita na cyklické přerušení,
    NVIC_SetPriority(RITIMER_IRQn, 7);
    NVIC_EnableIRQ(RITIMER_IRQn);
    Chip_SCT_Init(LPC_SCT0);
    LPC_GPIO->DIR[0] |= (1<<R_LED) | (1<<G_LED) | (1<<B_LED);
    LPC_SWM->PINASSIGN[7] = 0xffffffff;


    casovac1ms = 0;
    uint8_t sekvencer = 0;

    while(1) {

    	if ((casovac1ms % 1000) == 0) {
    		pc_in_report[63]++;
    		casovac1ms++;
    		//USBD_API->hw->WriteEP(g_hUsb,HID_EP_IN , pc_in_report, 64);
    	}

    	if (pc_out_report[0] & (1 << 0))	// 1 na nultem bitu (1 - 001)
    		LPC_GPIO->SET[0] = 1 << R_LED;
    	else
    		LPC_GPIO->CLR[0] = 1 << R_LED;


    	if (pc_out_report[0] & (1 << 1))	// 1 na prvnim bitu (2 - 010)
    		LPC_GPIO->SET[0] = 1 << G_LED;
    	else
    		LPC_GPIO->CLR[0] = 1 << G_LED;


    	if (pc_out_report[0] & (1 << 2))	// 1 na druhem bitu (4 - 100)
    		LPC_GPIO->SET[0] = 1 << B_LED;
    	else
    		LPC_GPIO->CLR[0] = 1 << B_LED;

    }
}

void RIT_IRQHandler(void) {
	LPC_RITIMER->CTRL |= 1; //zruseni priznaku preruseni
	casovac1ms++; //casovac 1 ms
}
