256592/Data_logger/01_Firmware-LPC/Test/LPC1549_USB_HID_ANALOG_TEST/usbd_rom_hid_generic/example/src/hid_generic.c

/*
 * @brief HID generic example's callabck routines
 *
 * @note
 * Copyright(C) NXP Semiconductors, 2013
 * All rights reserved.
 *
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
 * @par
 * Permission to use, copy, modify, and distribute this software and its
 * documentation is hereby granted, under NXP Semiconductors' and its
 * licensor's relevant copyrights in the software, without fee, provided that it
 * is used in conjunction with NXP Semiconductors microcontrollers.  This
 * copyright, permission, and disclaimer notice must appear in all copies of
 * this code.
 */

#include "board.h"
#include <stdint.h>
#include <string.h>
#include "usbd_rom_api.h"

/*****************************************************************************
 * Private types/enumerations/variables
 ****************************************************************************/



/*****************************************************************************
 * Public types/enumerations/variables
 ****************************************************************************/
extern uint8_t pc_out_report[64];
extern uint8_t pc_in_report[64];
extern const uint8_t HID_ReportDescriptor[];
extern const uint16_t HID_ReportDescSize;

/*****************************************************************************
 * Private functions
 ****************************************************************************/

/*  HID get report callback function. */
static ErrorCode_t HID_GetReport(USBD_HANDLE_T hHid, USB_SETUP_PACKET *pSetup, uint8_t * *pBuffer, uint16_t *plength)
{
	/* ReportID = SetupPacket.wValue.WB.L; */
	switch (pSetup->wValue.WB.H) {
	case HID_REPORT_INPUT:
		*pBuffer[0] = pc_in_report[0];
		*plength = 1;
		break;

	case HID_REPORT_OUTPUT:
		return ERR_USBD_STALL;			/* Not Supported */

	case HID_REPORT_FEATURE:
		return ERR_USBD_STALL;			/* Not Supported */
	}
	return LPC_OK;
}

/* HID set report callback function. */
static ErrorCode_t HID_SetReport(USBD_HANDLE_T hHid, USB_SETUP_PACKET *pSetup, uint8_t * *pBuffer, uint16_t length)
{
	/* we will reuse standard EP0Buf */
	if (length == 0) {
		return LPC_OK;
	}

	/* ReportID = SetupPacket.wValue.WB.L; */
	switch (pSetup->wValue.WB.H) {
	case HID_REPORT_INPUT:
		return ERR_USBD_STALL;			/* Not Supported */

	case HID_REPORT_OUTPUT:
		//*loopback_report = **pBuffer;
		pc_out_report[0] = *pBuffer[0];
		break;

	case HID_REPORT_FEATURE:
		return ERR_USBD_STALL;			/* Not Supported */
	}
	return LPC_OK;
}

/* HID Interrupt endpoint event handler. */
static ErrorCode_t HID_Ep_Hdlr(USBD_HANDLE_T hUsb, void *data, uint32_t event)
{
	USB_HID_CTRL_T *pHidCtrl = (USB_HID_CTRL_T *) data;

	switch (event) {
	case USB_EVT_IN:
		/* last report is successfully sent. Do something... */
		break;

	case USB_EVT_OUT:
		/* Read the new report received. */
		USBD_API->hw->ReadEP(hUsb, pHidCtrl->epout_adr, pc_out_report);
		break;
	}
	return LPC_OK;
}

/*****************************************************************************
 * Public functions
 ****************************************************************************/

/* HID init routine */
ErrorCode_t usb_hid_init(USBD_HANDLE_T hUsb,
						 USB_INTERFACE_DESCRIPTOR *pIntfDesc,
						 uint32_t *mem_base,
						 uint32_t *mem_size)
{
	USBD_HID_INIT_PARAM_T hid_param;
	USB_HID_REPORT_T reports_data[1];
	ErrorCode_t ret = LPC_OK;

	memset((void *) &hid_param, 0, sizeof(USBD_HID_INIT_PARAM_T));
	/* HID paramas */
	hid_param.max_reports = 1;
	/* Init reports_data */
	reports_data[0].len = HID_ReportDescSize;
	reports_data[0].idle_time = 0;
	reports_data[0].desc = (uint8_t *) &HID_ReportDescriptor[0];

	if ((pIntfDesc == 0) || (pIntfDesc->bInterfaceClass != USB_DEVICE_CLASS_HUMAN_INTERFACE)) {
		return ERR_FAILED;
	}

	hid_param.mem_base = *mem_base;
	hid_param.mem_size = *mem_size;
	hid_param.intf_desc = (uint8_t *) pIntfDesc;
	/* user defined functions */
	hid_param.HID_GetReport = HID_GetReport;
	hid_param.HID_SetReport = HID_SetReport;
	hid_param.HID_EpIn_Hdlr  = HID_Ep_Hdlr;
	hid_param.HID_EpOut_Hdlr = HID_Ep_Hdlr;
	hid_param.report_data  = reports_data;

	ret = USBD_API->hid->init(hUsb, &hid_param);
	/* allocate USB accessable memory space for report data */
	//loopback_report =  (uint8_t *) hid_param.mem_base;
	hid_param.mem_base += 64;
	hid_param.mem_size += 64;
	/* update memory variables */
	*mem_base = hid_param.mem_base;
	*mem_size = hid_param.mem_size;
	return ret;
}
