256592/Data_logger/(commit log)

2025-10-21 update components values
    [Data-logger_v01-01.brd, Data-logger_v01-01.sch]
2026-01-06 upload 3d model
    [krabicka_BP_rev3.step]
